BerndGottschlag/goboard/README.md

# GoBoard

This project contains the PCB design and the firmware for a compact modular
wireless mechanical keyboard.

## License

All hardware designes are licensed under the CERN Open Hardware License v1.2.
