BerndGottschlag/goboard/hardware/3dpackages/EG2315A/EG2315A.step

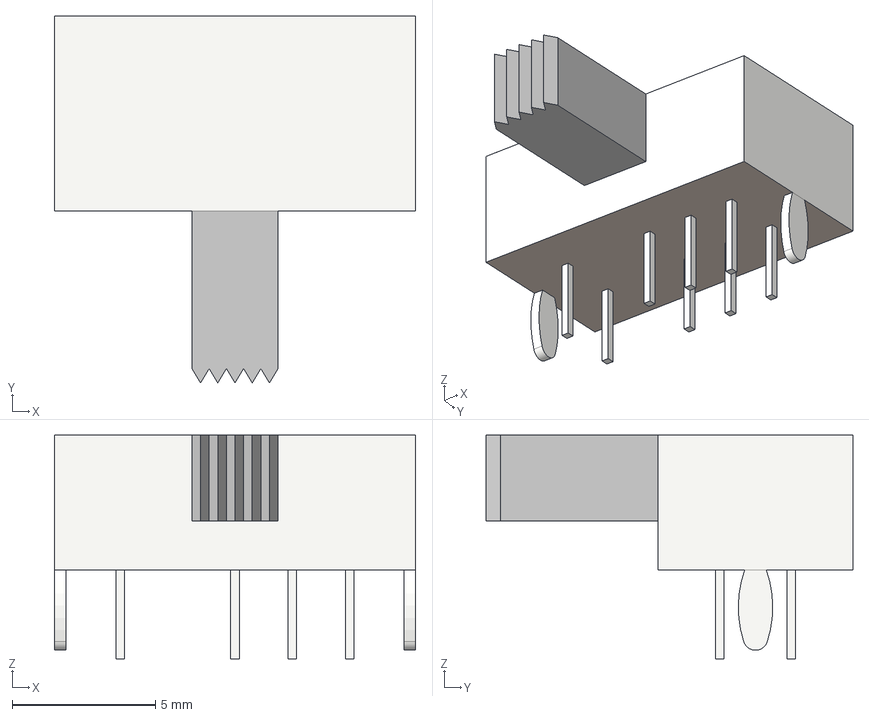
[picture p1: CAD file, 2021-01-24]
hardware/3dpackages/EG2315A/EG2315A.step
12.6 x 12.8 x 7.80 mm
