BerndGottschlag/goboard/hardware/3dpackages/stabilizers/stabilizer_bar_2_00u.FCStd

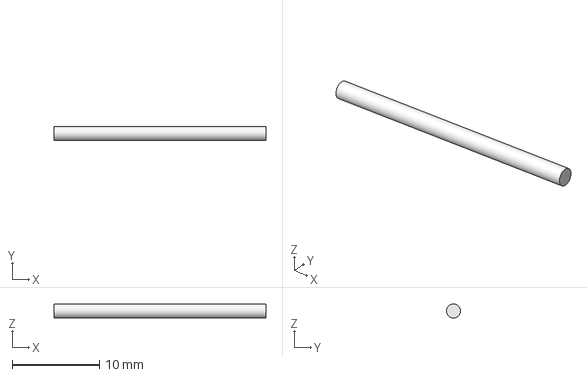
[picture p2: CAD file, 2021-02-06]
hardware/3dpackages/stabilizers/stabilizer_bar_2_00u.FCStd
24.3 x 1.60 x 1.60 mm
