BerndGottschlag/goboard/hardware/3dpackages/stabilizers/stabilizer_6_25u.FCStd

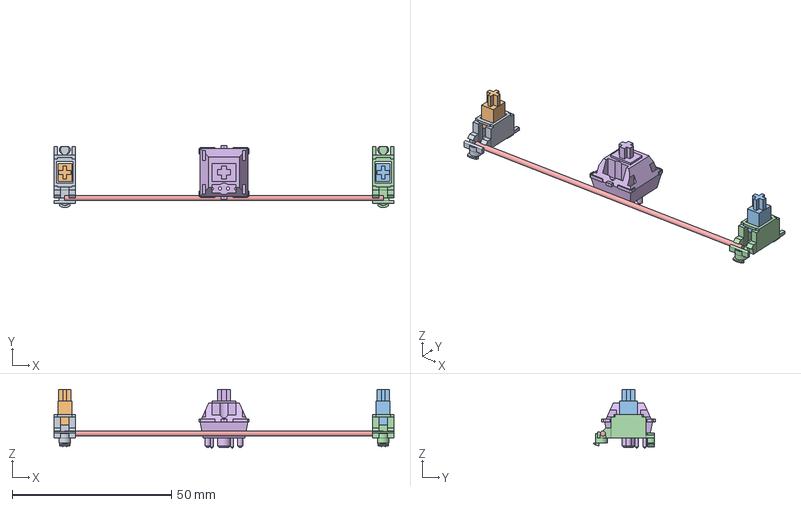
[picture p3: CAD file, 2021-02-06]
hardware/3dpackages/stabilizers/stabilizer_6_25u.FCStd
106.6 x 19.5 x 18.5 mm
stabilizer_body_001
stabilizer_plunger_001
stabilizer_plunger_002
stabilizer_body_002
stabilizer_bar_6_25u_001
SW_Cherry_MX_1.00u_PCB1_001
