BerndGottschlag/goboard/hardware/3dpackages/stabilizers/stabilizer_plunger.FCStd

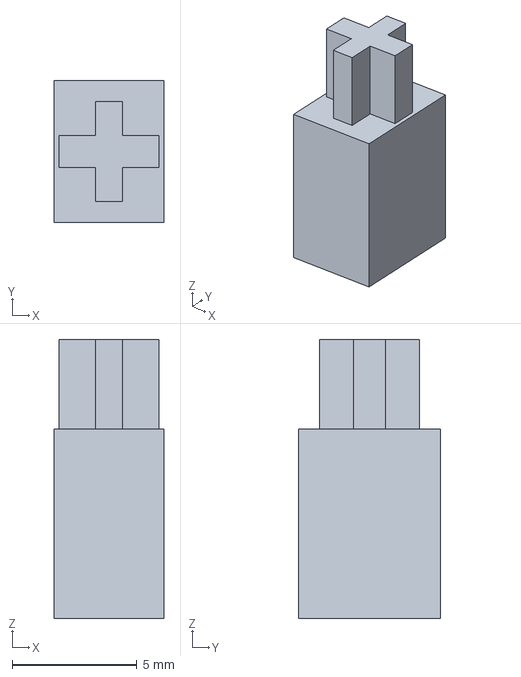
[picture p4: CAD file, 2021-02-06]
hardware/3dpackages/stabilizers/stabilizer_plunger.FCStd
4.40 x 5.70 x 11.2 mm
