BerndGottschlag/goboard/hardware/3dpackages/stabilizers/stabilizer_2_00u.FCStd

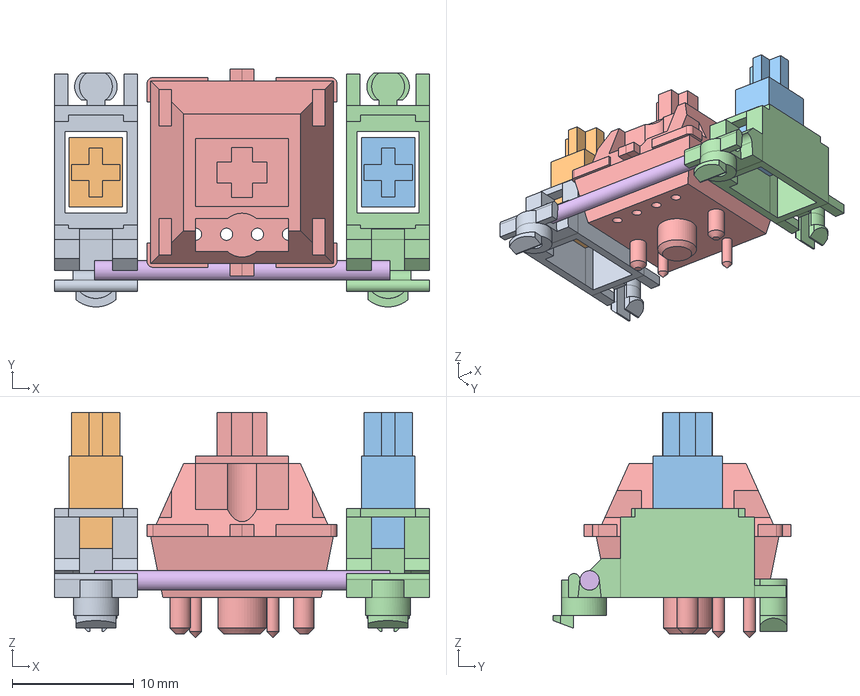
[picture p6: CAD file, 2021-02-06]
hardware/3dpackages/stabilizers/stabilizer_2_00u.FCStd
30.8 x 19.5 x 18.5 mm
stabilizer_body_001
stabilizer_plunger_001
stabilizer_plunger_002
stabilizer_body_002
SW_Cherry_MX_1.00u_PCB1_001
stabilizer_bar_2_00u_001
