BerndGottschlag/goboard/hardware/3dpackages/stabilizers/stabilizer_bar_6_25u.FCStd

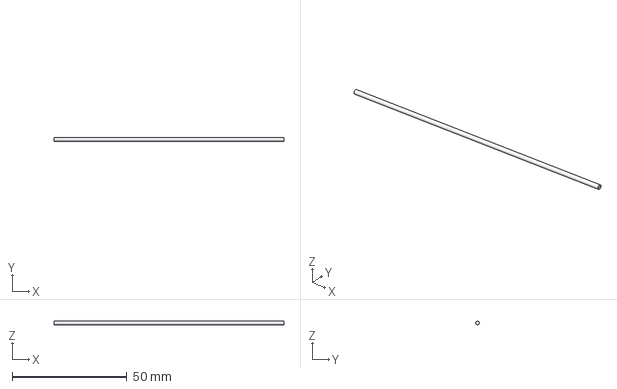
[picture p7: CAD file, 2021-02-06]
hardware/3dpackages/stabilizers/stabilizer_bar_6_25u.FCStd
100.0 x 1.60 x 1.60 mm
