BerndGottschlag/goboard/hardware/3dpackages/stabilizers/stabilizer_body.FCStd

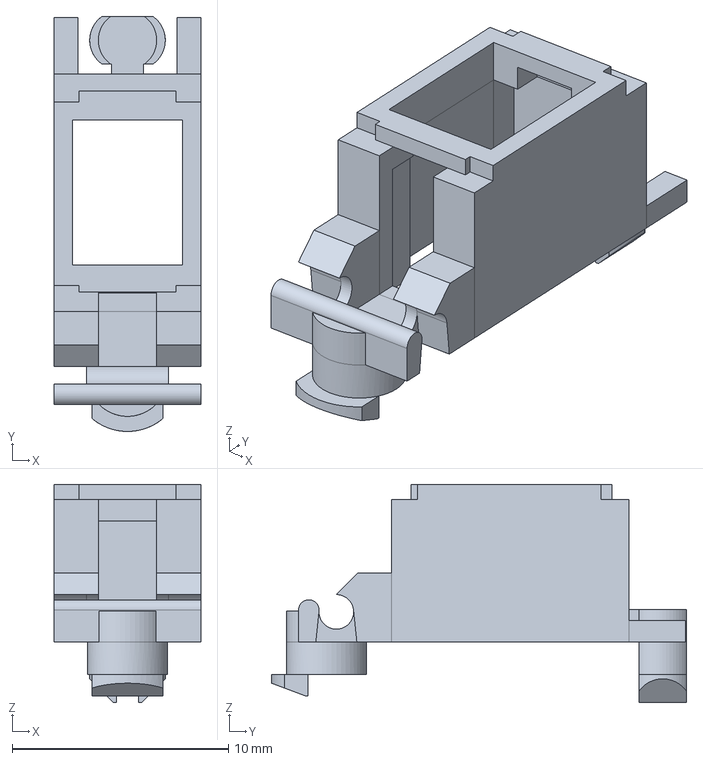
[picture p8: CAD file, 2021-02-06]
hardware/3dpackages/stabilizers/stabilizer_body.FCStd
6.80 x 19.2 x 10.1 mm
