BerndGottschlag/goboard/(list of files, cad)

Other CAD files:
hardware/Batteriehalter_v2.scad
hardware/3dpackages/EG2315A/EG2315A.FCStd
hardware/roundedcube.scad
