BerndGottschlag/goboard/(threads)

Thread 1 (2021-06-07):

How to compile firmware?

mrninhvn, 2021-06-07:
I have limited experience with nrf52-sdk, i still don't understand how to compile the firmware, can you give more instructions?
Thank you!

mgottschlag, 2021-06-07:
Sorry, I forgot to update the README.md when I exchanged the old NRF SDK with the NRF Connect SDK. See commit 54d23b0 for the new instructions.

To install the NRF Connect SDK, follow https://developer.nordicsemi.com/nRF_Connect_SDK/doc/latest/nrf/gs_installing.html - fetching the master branch of  [nrfconnect/sdk-nrf](https://github.com/nrfconnect/sdk-nrf) should work - if not, I am currently on nrfconnect/sdk-nrf@5a8085cd.

mrninhvn, 2021-06-07:
I got that error when building:
`-- Configuring incomplete, errors occurred!
FATAL ERROR: command exited with status 1: 'C:\Program Files\CMake\bin\cmake.EXE' '-DWEST_PYTHON=c:\python39\python.exe' '-BD:\Keyboard\goboard\firmware\main\build' '-SD:\Keyboard\goboard\firmware\main' -GNinja`

And i want to test unifying, how can i switch to unifying mode, thank you.

mgottschlag, 2021-06-20:
Oh, I completely forgot this issue.

1. Unifying code is only working in the old pre-nrf-connect-sdk firmware, i.e. BerndGottschlag/goboard@59bb7e6475d9e5f007e6ed9bba5a2c76e7c1f737. This version requires the regular nrf-sdk and does not use Zephyr. In this case, the old README.md contains the correct instructions to compile the firmware.
2. The error you are seeing is because you do not use the correct version of NCS. You need one with a sufficiently new Zephyr, because the code needs the new work queue API.

mrninhvn, 2021-07-22:
@mgottschlag Finally compiled the firmware, I'm working with this tree [https://github.com/BerndGottschlag/goboard/tree/59bb7e6475d9e5f007e6ed9bba5a2c76e7c1f737](url)
I don't understand how the `main.c` program works, can you explain it to me? Thank you.

mrninhvn, 2021-07-23:
I'm flash code and nothing run, even usb :(

mrninhvn, 2021-07-23:
@mgottschlag So unifying code doesn't work with Zephyr, right?

mrninhvn, 2021-08-28:
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

Hi, i complie [59bb7e6] and flash, but nothing work, even usb, can you help me? I using nrf5sdk 17.0.2, thank you.
