BerndGottschlag/goboard/hardware/numpad/goboard-numpad.kicad_pcb

## KiCad design hardware/numpad/goboard-numpad.kicad_pcb (2021-02-28)

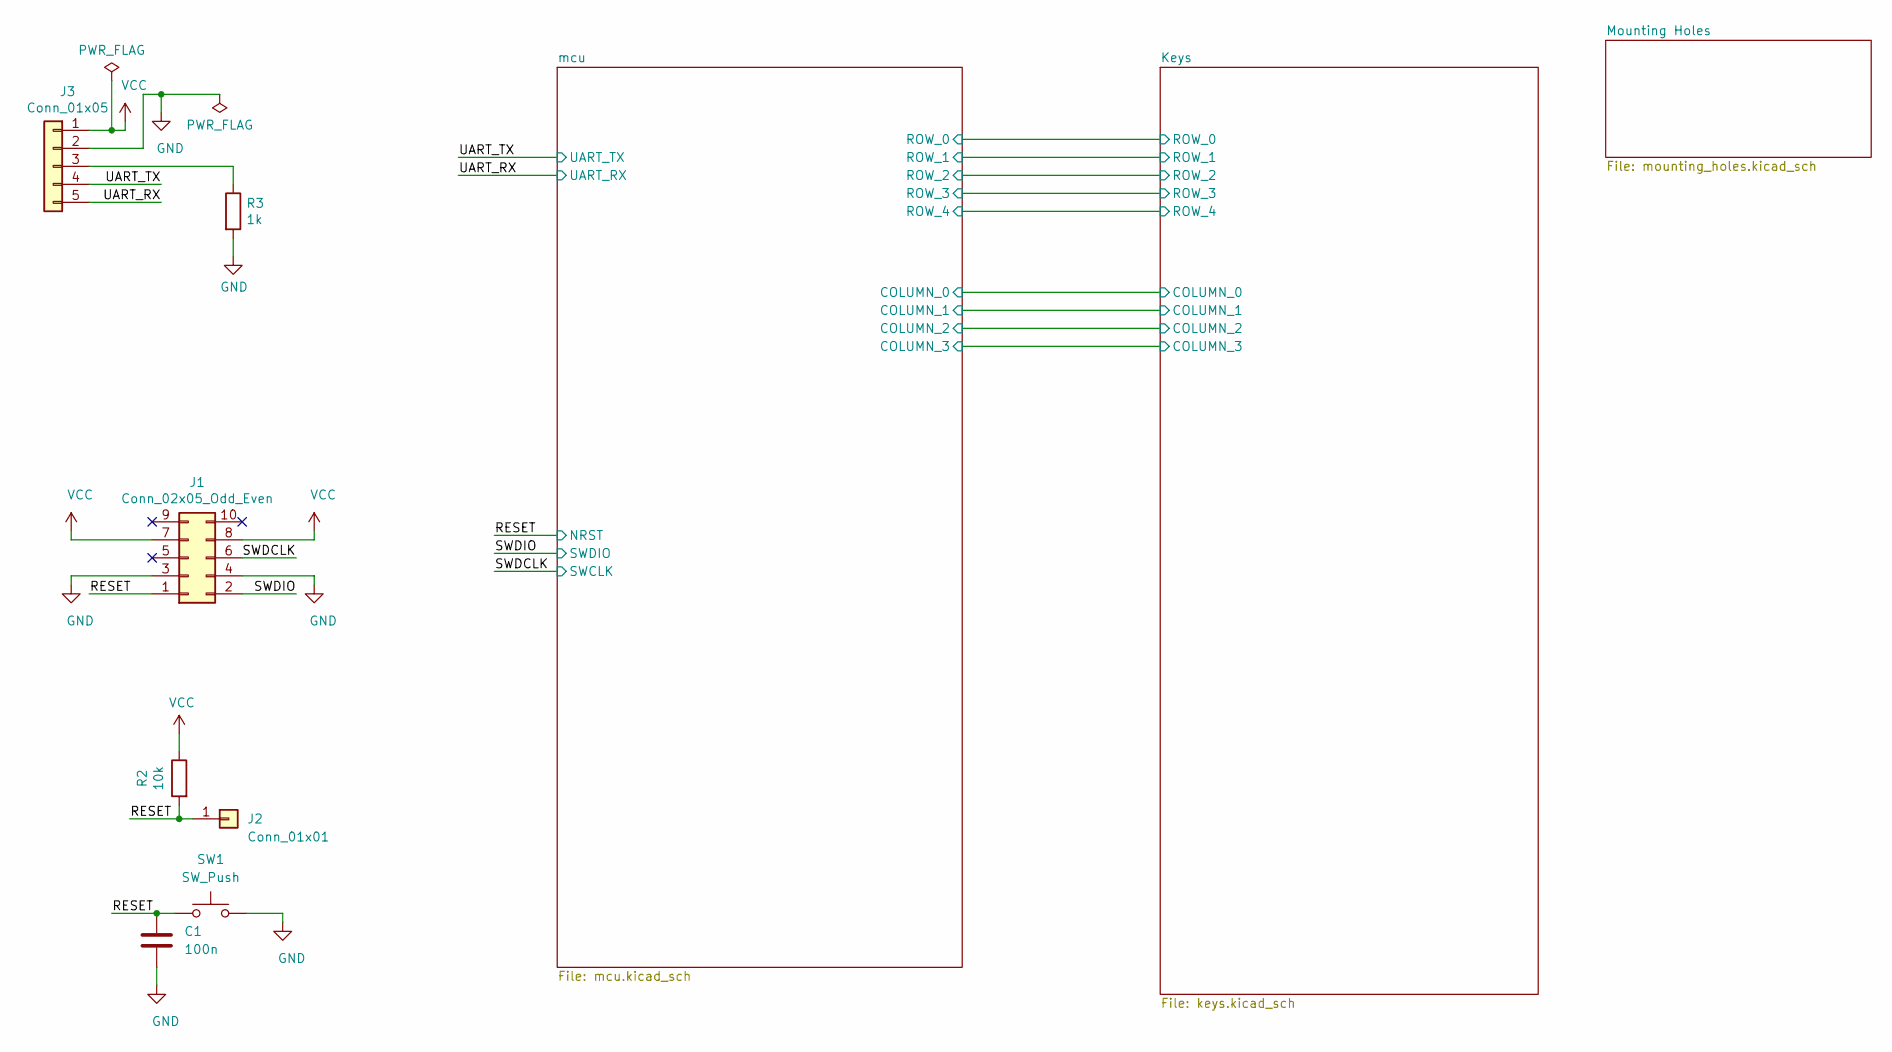
[picture p9: schematic goboard-numpad.kicad_sch]

Parts:
C1: 100n; C_0603_1608Metric_Pad1.08x0.95mm_HandSolder; Part Name AVX 0603YC104MAT4A; Mouser 581-0603YC104MAT4A
J1: Conn_02x05_Odd_Even; programming_port_st_link_clone_without_silkscreen_outline
J2: Conn_01x01; PinHeader_1x01_P2.54mm_Vertical
J3: Conn_01x05; PinHeader_1x05_P2.54mm_Vertical
R2: 10k; R_0603_1608Metric_Pad0.98x0.95mm_HandSolder
R3: 1k; R_0603_1608Metric_Pad0.98x0.95mm_HandSolder
SW1: SW_Push; SW_SPST_CK_RS282G05A3; Part Name PTS636 SM25 SMTR LFS; Mouser 611-PTS636SM25SMTRLF

Connections:
/RESET: C1.1, J1.1, J2.1, R2.2, SW1.1; also elsewhere on the board
/SWDCLK: J1.6; also elsewhere on the board
/SWDIO: J1.2; also elsewhere on the board
/UART_RX: J3.5; also elsewhere on the board
/UART_TX: J3.4; also elsewhere on the board
GND: C1.2, J1.3, J1.4, J3.2, R3.2, SW1.2; also elsewhere on the board
unnamed: J3.3, R3.1
VCC: J1.7, J1.8, J3.1, R2.1; also elsewhere on the board

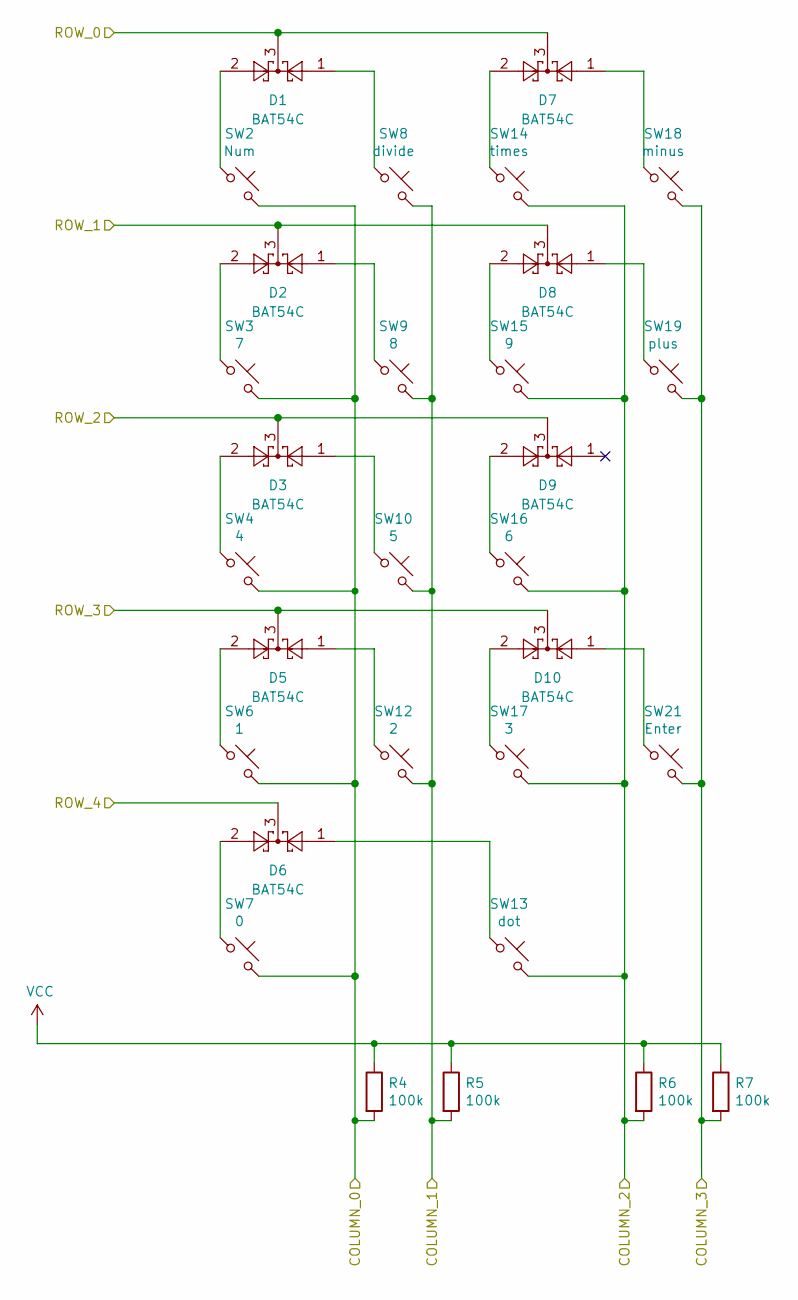
[picture p10: schematic keys.kicad_sch]

Parts:
D1, D2, D3, D5, D6, D7, D8, D9, D10: BAT54C; SOT-23; Part Name BAT54C; Mouser 241-BAT54C_R1_00001
R4, R5, R6, R7: 100k; R_0603_1608Metric_Pad0.98x0.95mm_HandSolder
SW2: Num; SW_Cherry_MX_1.00u_PCB; Part Name MX1A-E1NW; Mouser 540-MX1A-E1NW
SW3: 7; SW_Cherry_MX_1.00u_PCB; Part Name MX1A-E1NW; Mouser 540-MX1A-E1NW
SW4: 4; SW_Cherry_MX_1.00u_PCB; Part Name MX1A-E1NW; Mouser 540-MX1A-E1NW
SW6: 1; SW_Cherry_MX_1.00u_PCB; Part Name MX1A-E1NW; Mouser 540-MX1A-E1NW
SW7: 0; SW_Cherry_MX_2.00u_PCB; Part Name MX1A-E1NW; Mouser 540-MX1A-E1NW
SW8: divide; SW_Cherry_MX_1.00u_PCB; Part Name MX1A-E1NW; Mouser 540-MX1A-E1NW
SW9: 8; SW_Cherry_MX_1.00u_PCB; Part Name MX1A-E1NW; Mouser 540-MX1A-E1NW
SW10: 5; SW_Cherry_MX_1.00u_PCB; Part Name MX1A-E1NW; Mouser 540-MX1A-E1NW
SW12: 2; SW_Cherry_MX_1.00u_PCB; Part Name MX1A-E1NW; Mouser 540-MX1A-E1NW
SW13: dot; SW_Cherry_MX_1.00u_PCB; Part Name MX1A-E1NW; Mouser 540-MX1A-E1NW
SW14: times; SW_Cherry_MX_1.00u_PCB; Part Name MX1A-E1NW; Mouser 540-MX1A-E1NW
SW15: 9; SW_Cherry_MX_1.00u_PCB; Part Name MX1A-E1NW; Mouser 540-MX1A-E1NW
SW16: 6; SW_Cherry_MX_1.00u_PCB; Part Name MX1A-E1NW; Mouser 540-MX1A-E1NW
SW17: 3; SW_Cherry_MX_1.00u_PCB; Part Name MX1A-E1NW; Mouser 540-MX1A-E1NW
SW18: minus; SW_Cherry_MX_1.00u_PCB; Part Name MX1A-E1NW; Mouser 540-MX1A-E1NW
SW19: plus; SW_Cherry_MX_2.00u_PCB; Part Name MX1A-E1NW; Mouser 540-MX1A-E1NW
SW21: Enter; SW_Cherry_MX_2.00u_PCB; Part Name MX1A-E1NW; Mouser 540-MX1A-E1NW

Connections:
/Keys/COLUMN_0: R4.2, SW2.2, SW3.2, SW4.2, SW6.2, SW7.2; also elsewhere on the board
/Keys/COLUMN_1: R5.2, SW8.2, SW9.2, SW10.2, SW12.2; also elsewhere on the board
/Keys/COLUMN_2: R6.2, SW13.2, SW14.2, SW15.2, SW16.2, SW17.2; also elsewhere on the board
/Keys/COLUMN_3: R7.2, SW18.2, SW19.2, SW21.2; also elsewhere on the board
/Keys/ROW_0: D1.3, D7.3; also elsewhere on the board
/Keys/ROW_1: D2.3, D8.3; also elsewhere on the board
/Keys/ROW_2: D3.3, D9.3; also elsewhere on the board
/Keys/ROW_3: D5.3, D10.3; also elsewhere on the board
/Keys/ROW_4: D6.3; also elsewhere on the board
unnamed: D1.1, SW8.1
unnamed: D1.2, SW2.1
unnamed: D2.1, SW9.1
unnamed: D2.2, SW3.1
unnamed: D3.1, SW10.1
unnamed: D3.2, SW4.1
unnamed: D5.1, SW12.1
unnamed: D5.2, SW6.1
unnamed: D6.1, SW13.1
unnamed: D6.2, SW7.1
unnamed: D7.1, SW18.1
unnamed: D7.2, SW14.1
unnamed: D8.1, SW19.1
unnamed: D8.2, SW15.1
unnamed: D9.2, SW16.1
unnamed: D10.1, SW21.1
unnamed: D10.2, SW17.1
VCC: R4.1, R5.1, R6.1, R7.1; also elsewhere on the board

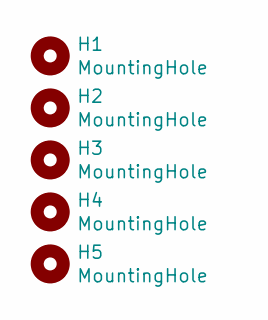
[picture p11: schematic mounting_holes.kicad_sch]

Parts:
H1, H2, H3, H4, H5: MountingHole; MountingHole_2.2mm_M2_Pad

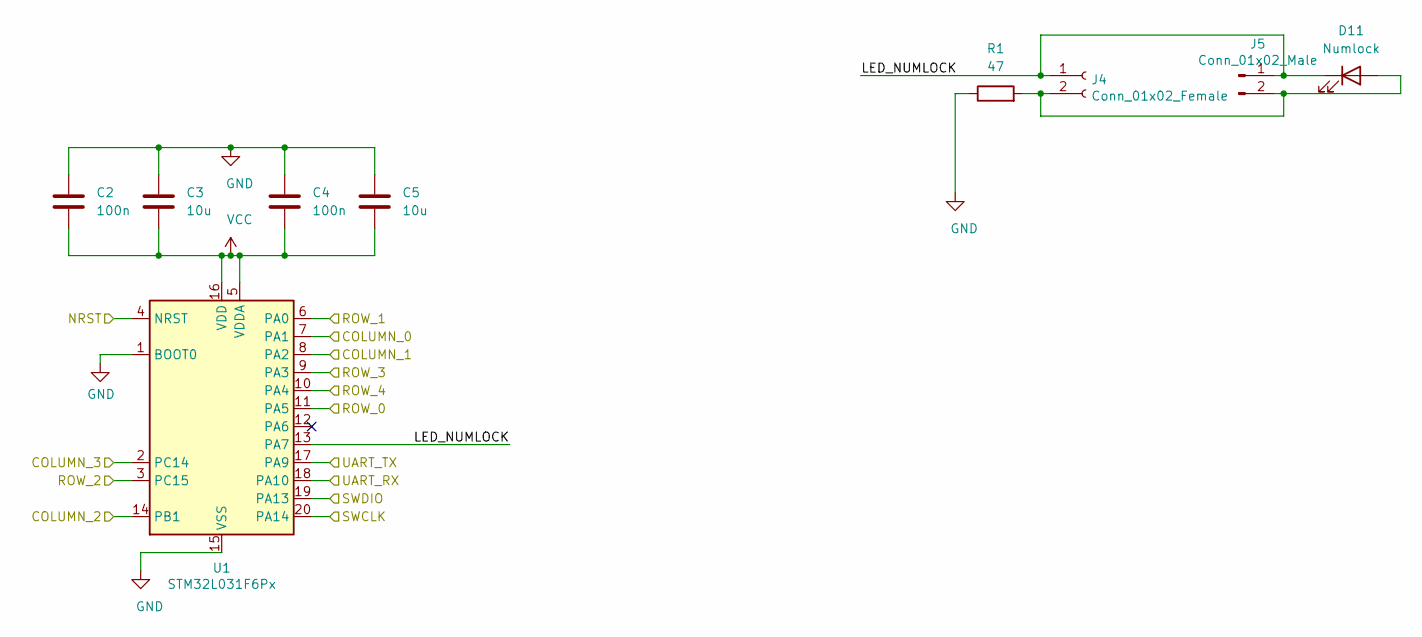
[picture p12: schematic mcu.kicad_sch]

Parts:
C2, C4: 100n; C_0603_1608Metric_Pad1.08x0.95mm_HandSolder; Part Name AVX 0603YC104MAT4A; Mouser 581-0603YC104MAT4A
C3, C5: 10u; C_0805_2012Metric; Part Name Samsung CL21A106KOQNNNG; Mouser 187-CL21A106KOQNNNG
D11: Numlock; D_0603_1608Metric_Pad1.05x0.95mm_HandSolder; Part Name 150060SS75000; Mouser 710-150060SS75000
J4: Conn_01x02_Female; PinSocket_1x02_P2.00mm_Vertical
J5: Conn_01x02_Male; PinSocket_1x02_P2.00mm_Vertical
R1: 47; R_0603_1608Metric_Pad0.98x0.95mm_HandSolder
U1: STM32L031F6Px; TSSOP-20_4.4x6.5mm_P0.65mm; Part Name STM32L031F6P7; Mouser 511-STM32L031F6P7

Connections:
/Keys/COLUMN_0: U1.7 (PA1); also elsewhere on the board
/Keys/COLUMN_1: U1.8 (PA2); also elsewhere on the board
/Keys/COLUMN_2: U1.14 (PB1); also elsewhere on the board
/Keys/COLUMN_3: U1.2 (PC14); also elsewhere on the board
/Keys/ROW_0: U1.11 (PA5); also elsewhere on the board
/Keys/ROW_1: U1.6 (PA0); also elsewhere on the board
/Keys/ROW_2: U1.3 (PC15); also elsewhere on the board
/Keys/ROW_3: U1.9 (PA3); also elsewhere on the board
/Keys/ROW_4: U1.10 (PA4); also elsewhere on the board
/RESET: U1.4 (NRST); also elsewhere on the board
/SWDCLK: U1.20 (PA14); also elsewhere on the board
/SWDIO: U1.19 (PA13); also elsewhere on the board
/UART_RX: U1.18 (PA10); also elsewhere on the board
/UART_TX: U1.17 (PA9); also elsewhere on the board
/mcu/LED_NUMLOCK: D11.1 (K), J4.1, J5.1, U1.13 (PA7)
GND: C2.1, C3.1, C4.1, C5.1, R1.1, U1.1 (BOOT0), U1.15 (VSS); also elsewhere on the board
unnamed: D11.2 (A), J4.2, J5.2, R1.2
VCC: C2.2, C3.2, C4.2, C5.2, U1.5 (VDDA), U1.16 (VDD); also elsewhere on the board

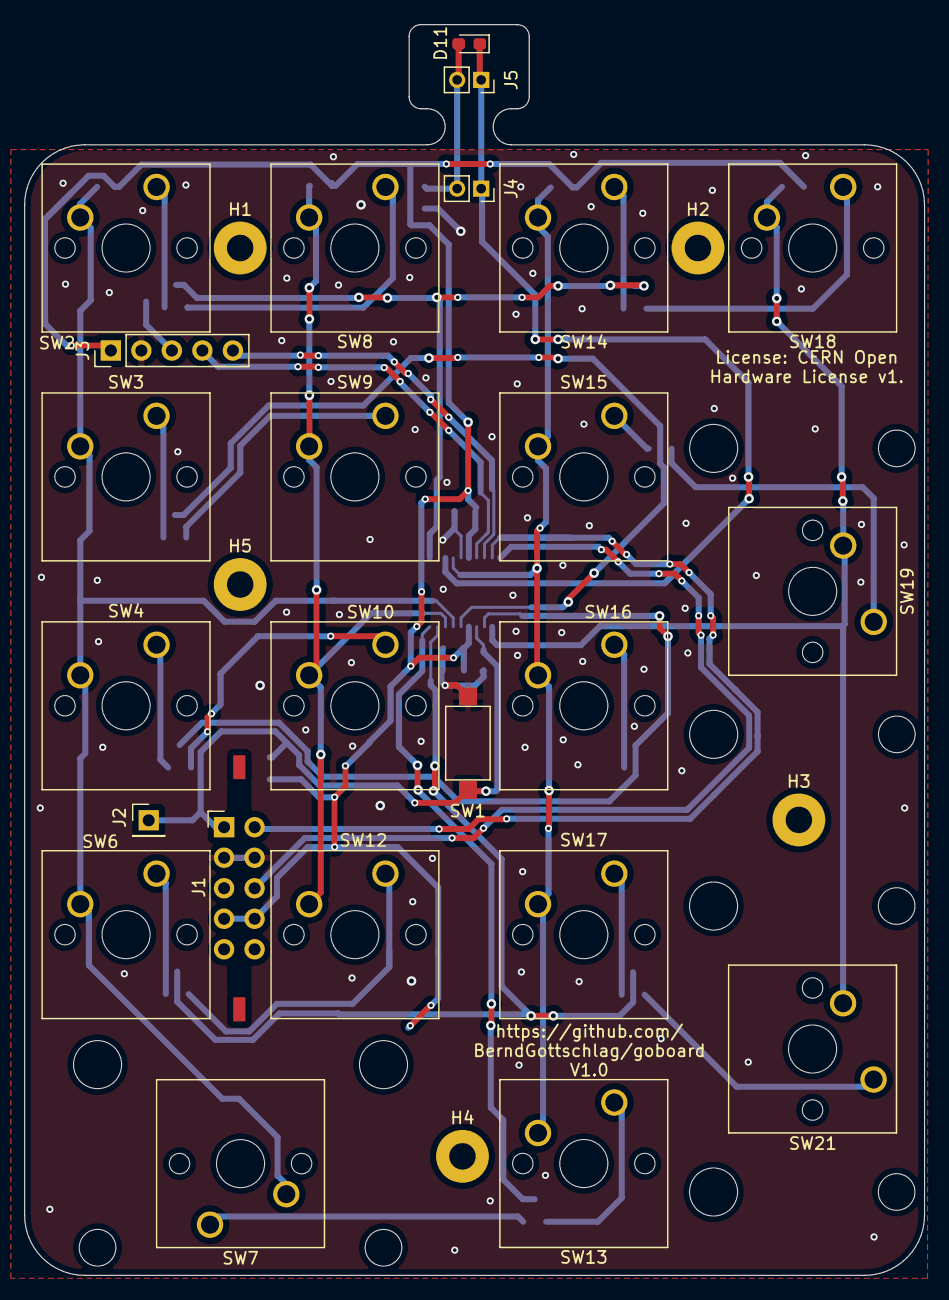
[picture p13: board goboard-numpad.kicad_pcb from above]

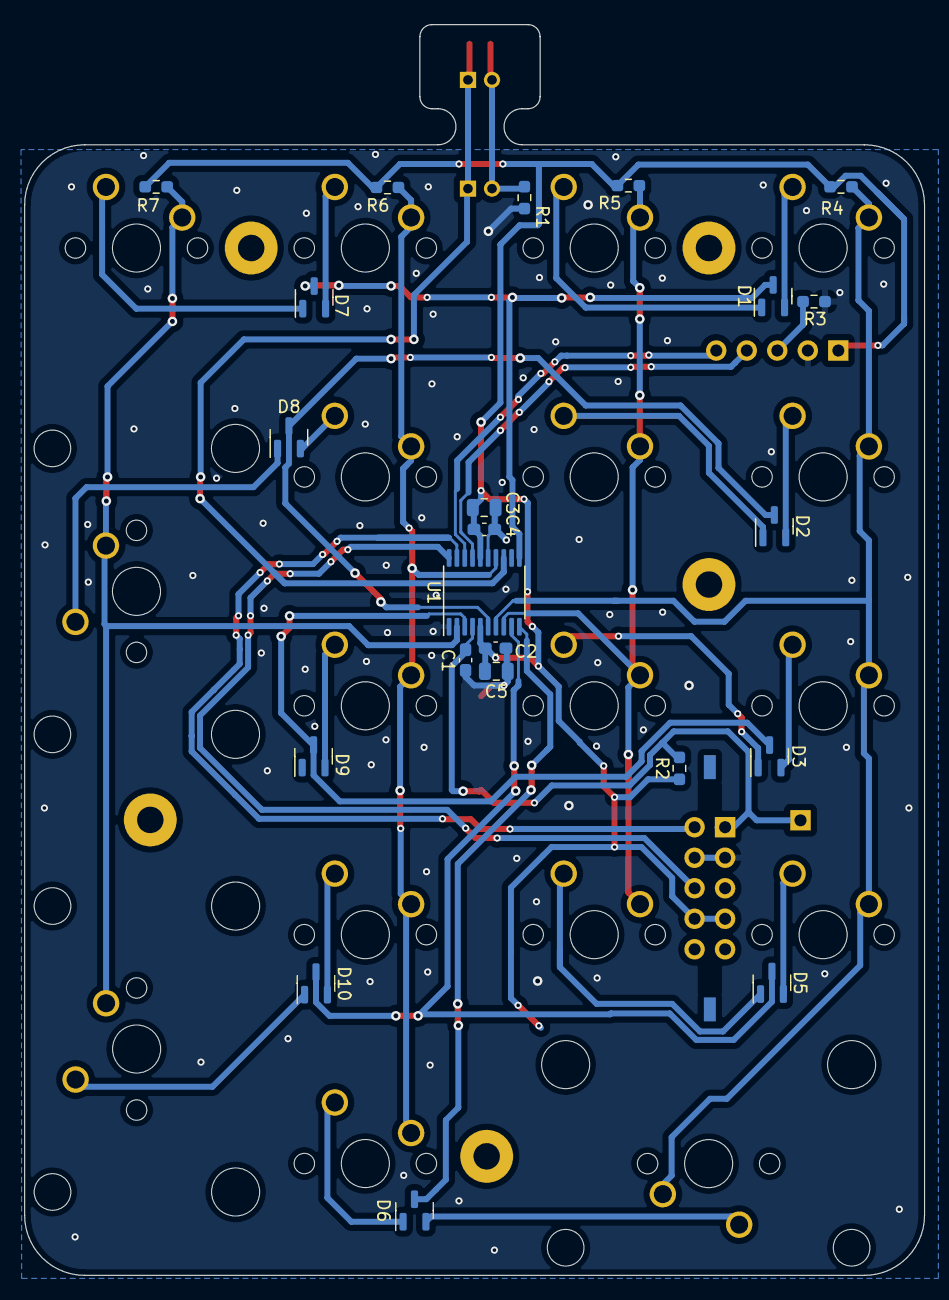
[picture p14: board goboard-numpad.kicad_pcb from below]

Board: 2 copper layers, 74.9 x 104.1 mm, 51 parts (22 on the bottom side), 36 nets.
