BerndGottschlag/goboard/hardware/main/goboard-main.kicad_pcb

## KiCad design hardware/main/goboard-main.kicad_pcb (2021-02-02)

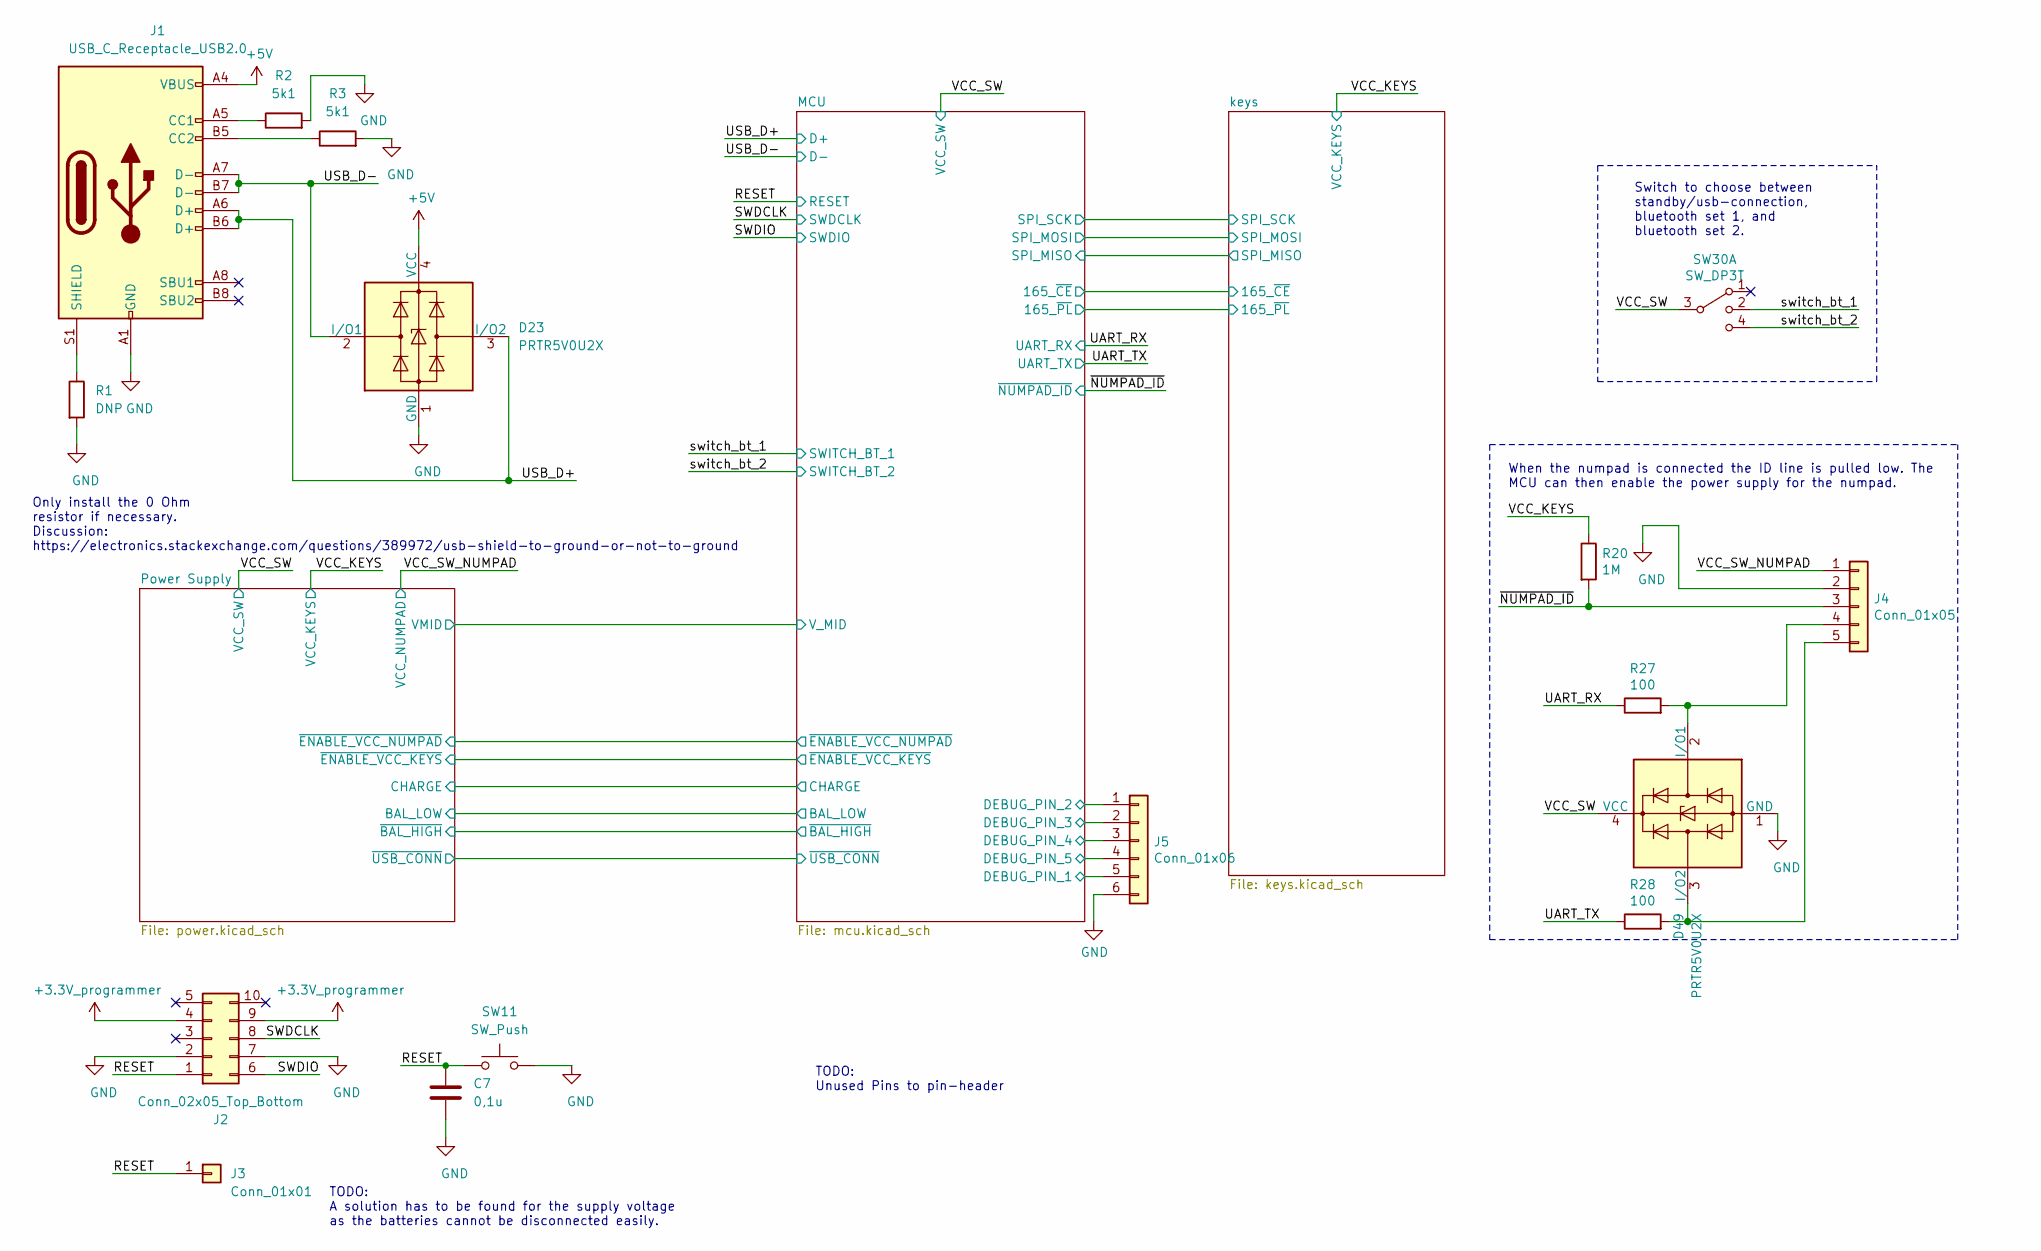
[picture p15: schematic goboard-main.kicad_sch]

Parts:
C7: 0,1u; C_0603_1608Metric_Pad1.08x0.95mm_HandSolder; Part Name 06033C104KAT4A; Mouser 581-06033C104KAT4A
D23, D49: PRTR5V0U2X; SOT-143; Part Name PRTR5V0U2X,215; Mouser 771-PRTR5V0U2X-T/R
J1: USB_C_Receptacle_USB2.0; USB_C_Receptale_JAE_DX07S016JA1R1500; Part Name DX07S016JA1R1500; Mouser 656-DX07S016JA1R1500
J2: Conn_02x05_Top_Bottom; programming_port_st_link_clone
J3: Conn_01x01; PinHeader_1x01_P2.54mm_Vertical
J4: Conn_01x05; PinHeader_1x05_P2.54mm_Vertical
J5: Conn_01x06; PinHeader_1x06_P2.54mm_Vertical
R1: DNP; R_0603_1608Metric_Pad0.98x0.95mm_HandSolder
R2, R3: 5k1; R_0603_1608Metric_Pad0.98x0.95mm_HandSolder
R20: 1M; R_0603_1608Metric_Pad0.98x0.95mm_HandSolder
R27, R28: 100; R_0603_1608Metric_Pad0.98x0.95mm_HandSolder
SW11: SW_Push; SW_SPST_CK_RS282G05A3; Part Name PTS636 SM25 SMTR LFS; Mouser 611-PTS636SM25SMTRLF
SW30: SW_DP3T; EG2315A; Part Name EG2315A; Mouser 612-EG2315A

Connections:
+5V: D23.4 (VCC), J1.A4 (VBUS), J1.A9 (VBUS), J1.B4 (VBUS), J1.B9 (VBUS); also elsewhere on the board
/MCU/DEBUG_PIN_1: J5.5; also elsewhere on the board
/MCU/DEBUG_PIN_2: J5.1; also elsewhere on the board
/MCU/DEBUG_PIN_3: J5.2; also elsewhere on the board
/MCU/DEBUG_PIN_4: J5.3; also elsewhere on the board
/MCU/DEBUG_PIN_5: J5.4; also elsewhere on the board
/RESET: C7.1, J2.1, J3.1, SW11.1; also elsewhere on the board
/SWDCLK: J2.8; also elsewhere on the board
/SWDIO: J2.6; also elsewhere on the board
/UART_RX: R27.1; also elsewhere on the board
/UART_TX: R28.1; also elsewhere on the board
/USB_D+: D23.3 (I/O2), J1.A6 (D+), J1.B6 (D+); also elsewhere on the board
/USB_D-: D23.2 (I/O1), J1.A7 (D-), J1.B7 (D-); also elsewhere on the board
/VCC_KEYS: R20.1; also elsewhere on the board
/VCC_SW: D49.4 (VCC), SW30.3; also elsewhere on the board
/VCC_SW_NUMPAD: J4.1; also elsewhere on the board
/switch_bt_1: SW30.2; also elsewhere on the board
/switch_bt_2: SW30.4; also elsewhere on the board
/~NUMPAD_ID: J4.3, R20.2; also elsewhere on the board
GND: C7.2, D23.1 (GND), D49.1 (GND), J1.A1 (GND), J1.A12 (GND), J1.B1 (GND), J1.B12 (GND), J2.2, J2.7, J4.2, J5.6, R1.2, R2.2, R3.2, SW11.2; also elsewhere on the board
unnamed: D49.2 (I/O1), J4.4, R27.2
unnamed: D49.3 (I/O2), J4.5, R28.2
unnamed: J1.A5 (CC1), R2.1
unnamed: J1.B5 (CC2), R3.1
unnamed: J1.S1 (SHIELD), R1.1

Notes on the sheet:
Only install the 0 Ohm resistor if necessary. Discussion: https://electronics.stackexchange.com/questions/389972/usb-shield-to-ground-or-not-to-ground
TODO: A solution has to be found for the supply voltage as the batteries cannot be disconnected easily.
TODO: Unused Pins to pin-header
When the numpad is connected the ID line is pulled low. The MCU can then enable the power supply for the numpad.
Switch to choose between standby/usb-connection, bluetooth set 1, and bluetooth set 2.

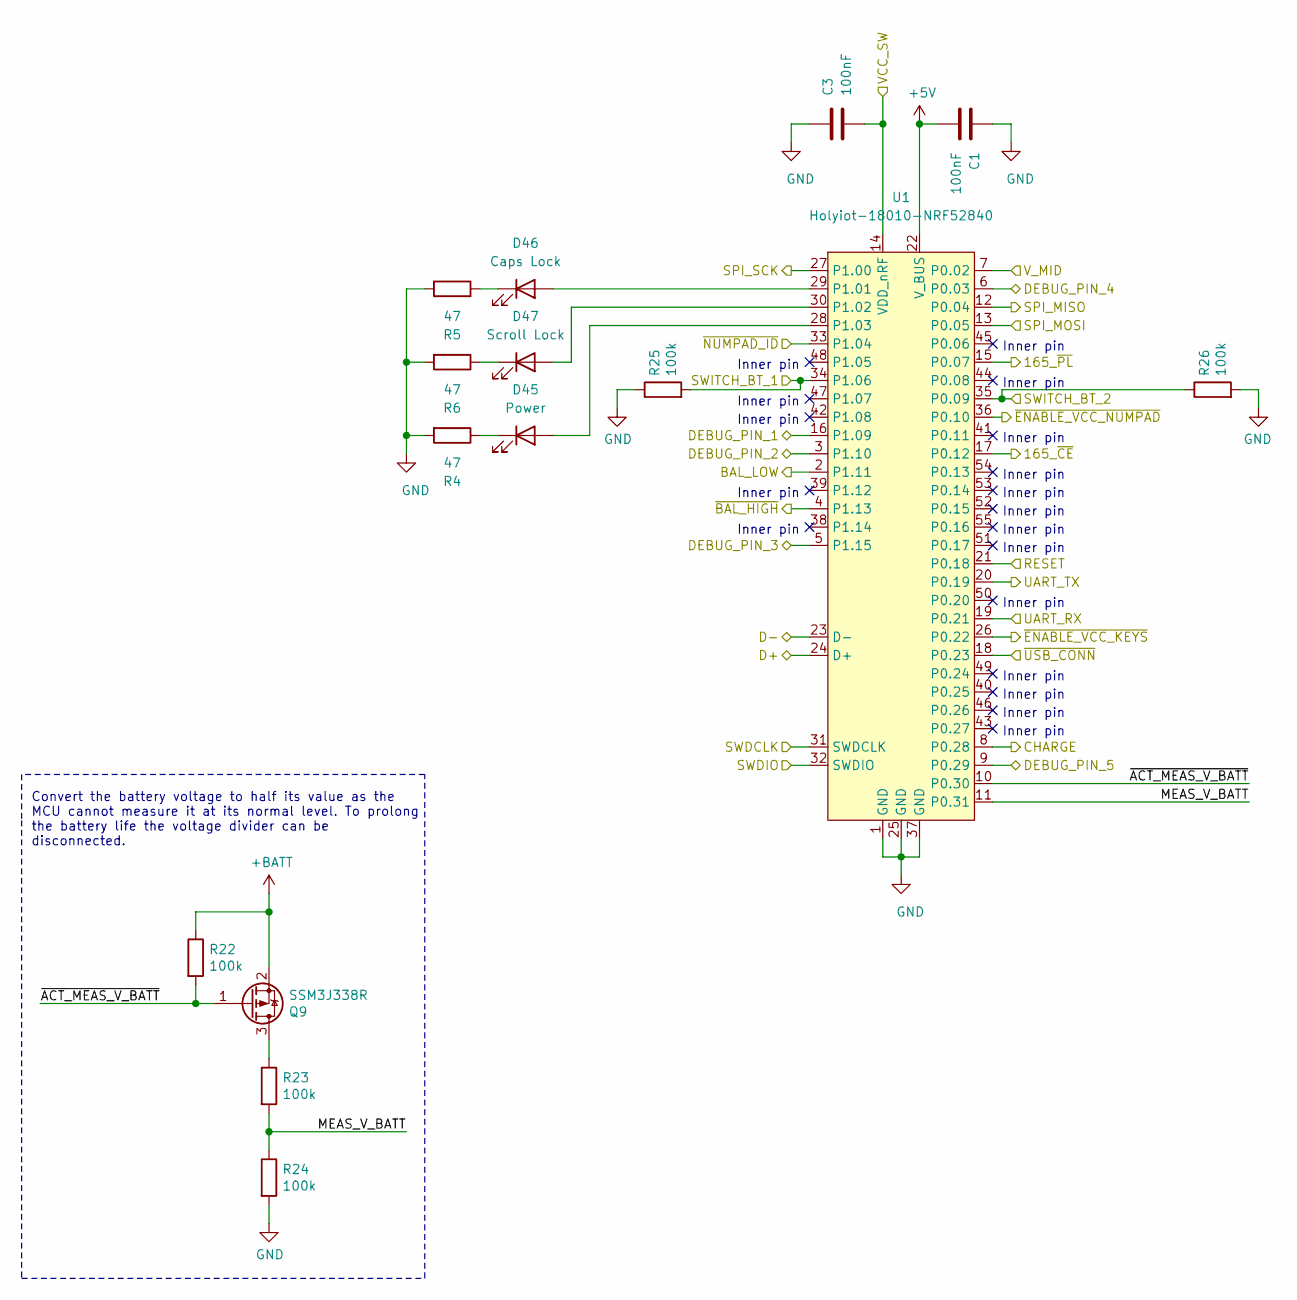
[picture p16: schematic mcu.kicad_sch]

Parts:
C1, C3: 100nF; C_0603_1608Metric_Pad1.08x0.95mm_HandSolder; Part Name 06033C104KAT4A; Mouser 581-06033C104KAT4A
D45: Power; D_0603_1608Metric_Pad1.05x0.95mm_HandSolder; Part Name 150060SS75000; Mouser 710-150060SS75000
D46: Caps Lock; D_0603_1608Metric_Pad1.05x0.95mm_HandSolder; Part Name 150060SS75000; Mouser 710-150060SS75000
D47: Scroll Lock; D_0603_1608Metric_Pad1.05x0.95mm_HandSolder; Part Name 150060SS75000; Mouser 710-150060SS75000
Q9: SSM3J338R; SOT-23_Handsoldering; Part Name Toshiba SSM3J338R; Mouser 757-SSM3J338RLF
R4, R5, R6: 47; R_0603_1608Metric_Pad0.98x0.95mm_HandSolder
R22, R23, R24, R25, R26: 100k; R_0603_1608Metric_Pad0.98x0.95mm_HandSolder
U1: Holyiot-18010-NRF52840

Connections:
+5V: C1.2, U1.22 (V_BUS); also elsewhere on the board
+BATT: Q9.2 (S), R22.1; also elsewhere on the board
/MCU/165_~CE: U1.17 (P0.12); also elsewhere on the board
/MCU/165_~PL: U1.15 (P0.07); also elsewhere on the board
/MCU/BAL_LOW: U1.2 (P1.11); also elsewhere on the board
/MCU/CHARGE: U1.8 (P0.28); also elsewhere on the board
/MCU/DEBUG_PIN_1: U1.16 (P1.09); also elsewhere on the board
/MCU/DEBUG_PIN_2: U1.3 (P1.10); also elsewhere on the board
/MCU/DEBUG_PIN_3: U1.5 (P1.15); also elsewhere on the board
/MCU/DEBUG_PIN_4: U1.6 (P0.03); also elsewhere on the board
/MCU/DEBUG_PIN_5: U1.9 (P0.29); also elsewhere on the board
/MCU/MEAS_V_BATT: R23.2, R24.1, U1.11 (P0.31)
/MCU/SPI_MISO: U1.12 (P0.04); also elsewhere on the board
/MCU/SPI_MOSI: U1.13 (P0.05); also elsewhere on the board
/MCU/SPI_SCK: U1.27 (P1.00); also elsewhere on the board
/MCU/V_MID: U1.7 (P0.02); also elsewhere on the board
/MCU/~ACT_MEAS_V_BATT: Q9.1 (G), R22.2, U1.10 (P0.30)
/MCU/~BAL_HIGH: U1.4 (P1.13); also elsewhere on the board
/MCU/~ENABLE_VCC_KEYS: U1.26 (P0.22); also elsewhere on the board
/MCU/~ENABLE_VCC_NUMPAD: U1.36 (P0.10); also elsewhere on the board
/MCU/~USB_CONN: U1.18 (P0.23); also elsewhere on the board
/RESET: U1.21 (P0.18); also elsewhere on the board
/SWDCLK: U1.31 (SWDCLK); also elsewhere on the board
/SWDIO: U1.32 (SWDIO); also elsewhere on the board
/UART_RX: U1.19 (P0.21); also elsewhere on the board
/UART_TX: U1.20 (P0.19); also elsewhere on the board
/USB_D+: U1.24 (D+); also elsewhere on the board
/USB_D-: U1.23 (D-); also elsewhere on the board
/VCC_SW: C3.2, U1.14 (VDD_nRF); also elsewhere on the board
/switch_bt_1: R25.2, U1.34 (P1.06); also elsewhere on the board
/switch_bt_2: R26.1, U1.35 (P0.09); also elsewhere on the board
/~NUMPAD_ID: U1.33 (P1.04); also elsewhere on the board
GND: C1.1, C3.1, R4.2, R5.2, R6.2, R24.2, R25.1, R26.2, U1.1 (GND), U1.25 (GND), U1.37 (GND); also elsewhere on the board
unnamed: D45.1 (K), R4.1
unnamed: D45.2 (A), U1.28 (P1.03)
unnamed: D46.1 (K), R5.1
unnamed: D46.2 (A), U1.29 (P1.01)
unnamed: D47.1 (K), R6.1
unnamed: D47.2 (A), U1.30 (P1.02)
unnamed: Q9.3 (D), R23.1

Notes on the sheet:
Convert the battery voltage to half its value as the MCU cannot measure it at its normal level. To prolong the battery life the voltage divider can be disconnected.
Inner pin

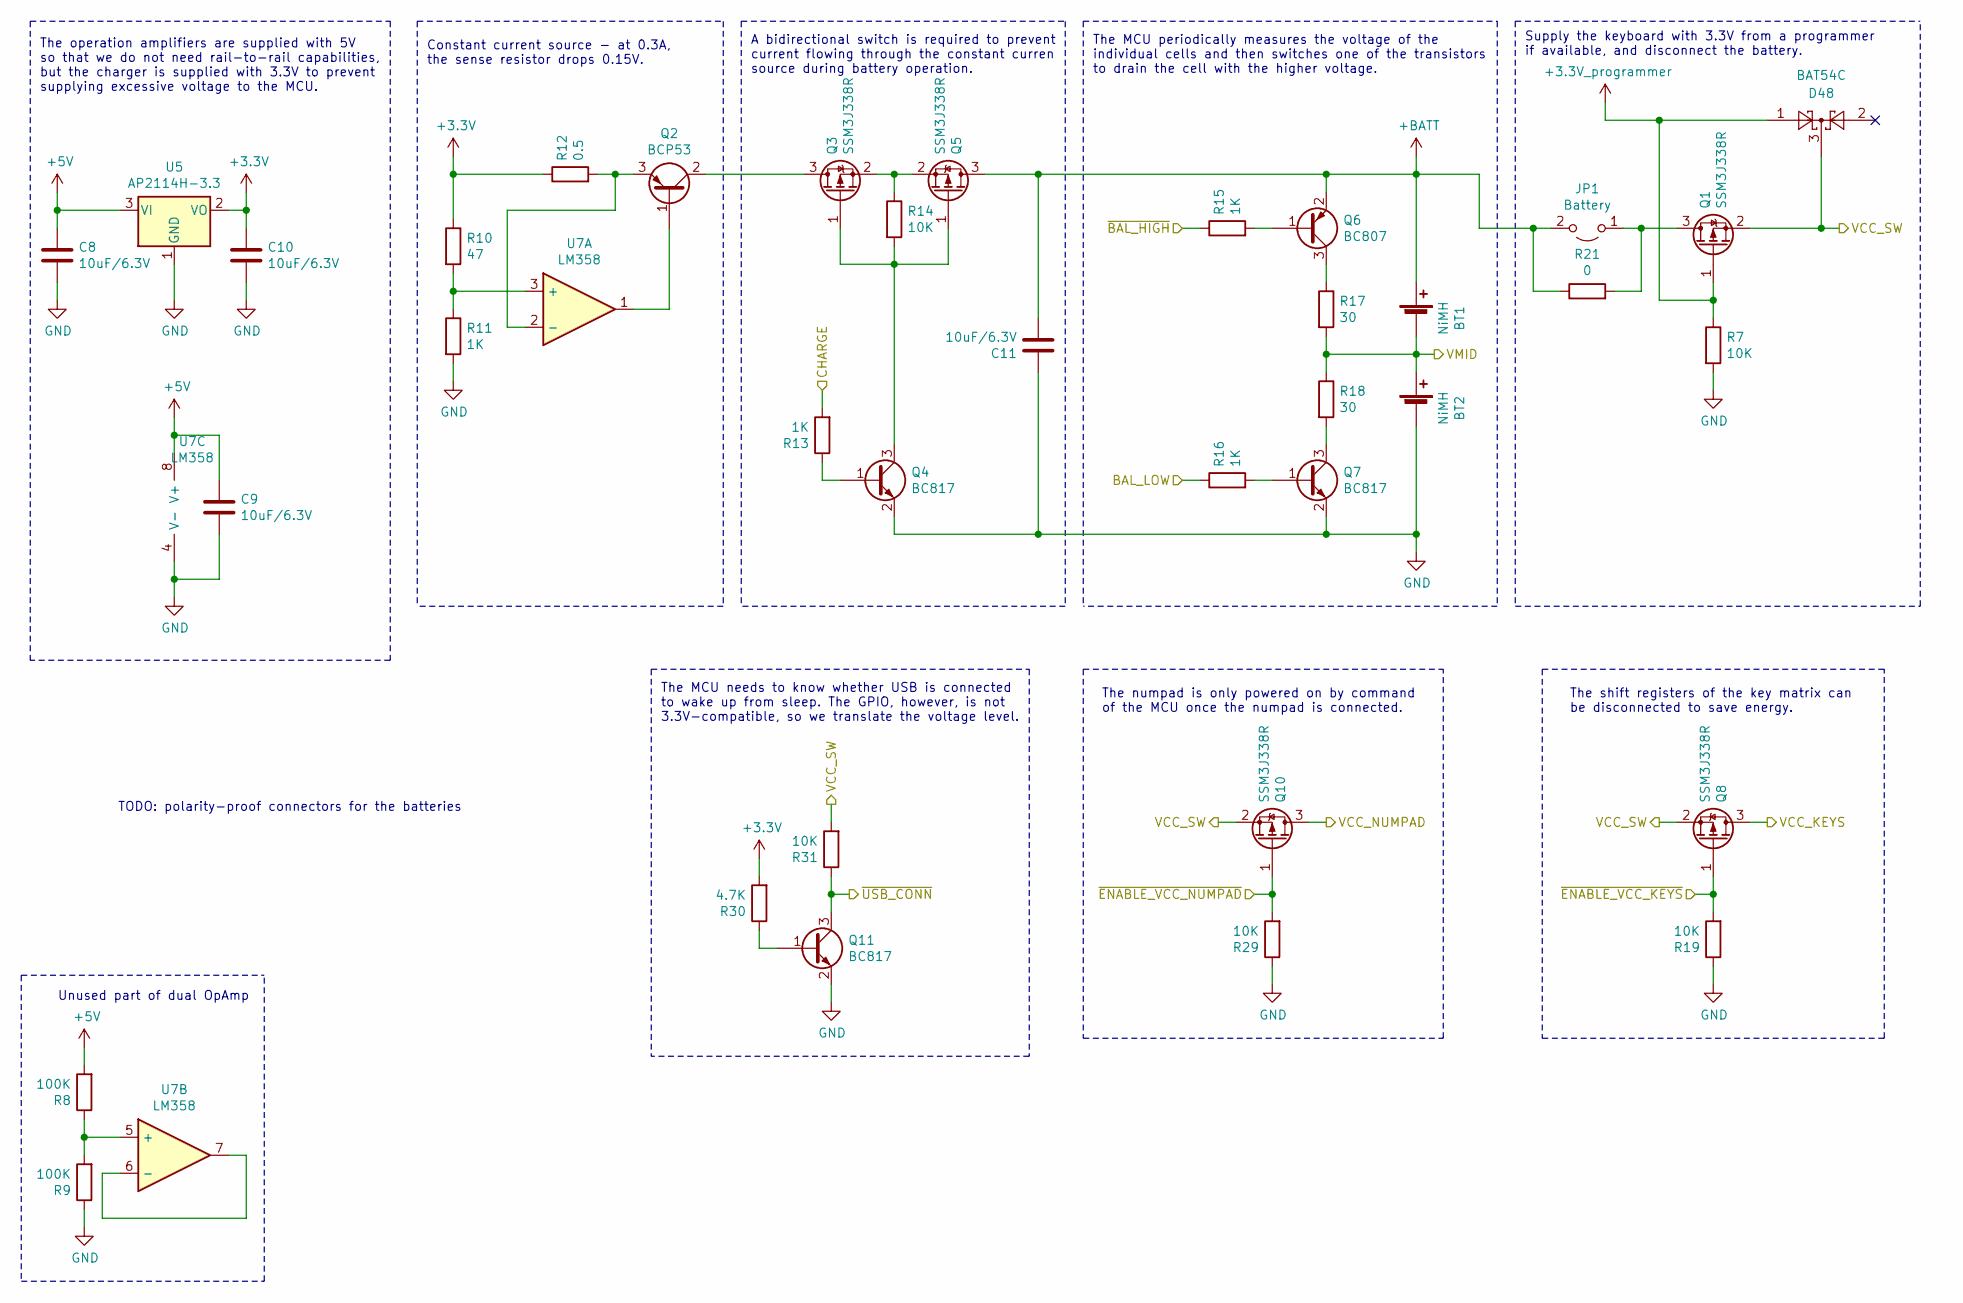
[picture p17: schematic power.kicad_sch]

Parts:
BT1, BT2: NiMH; JST_XH_S2B-XH-A_1x02_P2.50mm_Horizontal
C8, C9, C10, C11: 10uF/6.3V; C_0805_2012Metric; Part Name Taiyo Yuden LMK212F106ZG-T; Mouser 963-LMK212F106ZG-T
D48: BAT54C; SOT-23; Part Name BAT54A; Mouser 241-BAT54A_R1_00001
JP1: Battery; PinHeader_1x02_P2.54mm_Horizontal
Q1, Q3, Q5, Q8, Q10: SSM3J338R; SOT-23_Handsoldering; Part Name Toshiba SSM3J338R; Mouser 757-SSM3J338RLF
Q2: BCP53; SOT-223; Part Name Nexperia BCP53TF; Mouser 771-BCP53TF
Q4, Q7, Q11: BC817; SOT-23
Q6: BC807; SOT-23
R7, R14, R19, R29, R31: 10K; R_0603_1608Metric
R8, R9: 100K; R_0603_1608Metric
R10: 47; R_0603_1608Metric
R11, R13, R15, R16: 1K; R_0603_1608Metric
R12: 0.5; R_1206_3216Metric; Part Name Ohmite KDV12FR510ET; Mouser 588-KDV12FR510ET
R17, R18: 30; R_0603_1608Metric
R21: 0; R_0603_1608Metric_Pad0.98x0.95mm_HandSolder
R30: 4.7K; R_0603_1608Metric
U5: AP2114H-3.3; SOT-223-3_TabPin2; Part Name Diodes Inc AP2114H-3.3TRG1; Mouser 621-AP2114H-3.3TRG1
U7: LM358

Connections:
+5V: C8.1, C9.1, R8.2, U5.3 (VI), U7.8 (V+); also elsewhere on the board
+BATT: BT1.1 (+), C11.2, JP1.2 (B), Q5.3 (D), Q6.2 (E), R21.1; also elsewhere on the board
/MCU/BAL_LOW: R16.1; also elsewhere on the board
/MCU/CHARGE: R13.2; also elsewhere on the board
/MCU/V_MID: BT1.2 (-), BT2.1 (+), R17.2, R18.1; also elsewhere on the board
/MCU/~BAL_HIGH: R15.1; also elsewhere on the board
/MCU/~ENABLE_VCC_KEYS: Q8.1 (G), R19.2; also elsewhere on the board
/MCU/~ENABLE_VCC_NUMPAD: Q10.1 (G), R29.2; also elsewhere on the board
/MCU/~USB_CONN: Q11.3 (C), R31.1; also elsewhere on the board
/VCC_KEYS: Q8.3 (D); also elsewhere on the board
/VCC_SW: D48.3, Q1.2 (S), Q8.2 (S), Q10.2 (S), R31.2; also elsewhere on the board
/VCC_SW_NUMPAD: Q10.3 (D); also elsewhere on the board
GND: BT2.2 (-), C8.2, C9.2, C10.2, C11.1, Q4.2 (E), Q7.2 (E), Q11.2 (E), R7.2, R9.1, R11.2, R19.1, R29.1, U5.1 (GND), U7.4 (V-); also elsewhere on the board
unnamed: JP1.1 (A), Q1.3 (D), R21.2
unnamed: Q2.1 (B), U7.1
unnamed: Q2.2 (C), Q2.4 (C), Q3.3 (D)
unnamed: Q2.3 (E), R12.2, U7.2 (-)
unnamed: Q3.1 (G), Q4.3 (C), Q5.1 (G), R14.2
unnamed: Q3.2 (S), Q5.2 (S), R14.1
unnamed: Q4.1 (B), R13.1
unnamed: Q6.1 (B), R15.2
unnamed: Q6.3 (C), R17.1
unnamed: Q7.1 (B), R16.2
unnamed: Q7.3 (C), R18.2
unnamed: Q11.1 (B), R30.1
unnamed: R8.1, R9.2, U7.5 (+)
unnamed: R10.2, R11.1, U7.3 (+)
unnamed: U7.6 (-), U7.7

Notes on the sheet:
The operation amplifiers are supplied with 5V so that we do not need rail-to-rail capabilities, but the charger is supplied with 3.3V to prevent supplying excessive voltage to the MCU.
Unused part of dual OpAmp
Constant current source - at 0.3A, the sense resistor drops 0.15V.
TODO: polarity-proof connectors for the batteries
The MCU needs to know whether USB is connected to wake up from sleep. The GPIO, however, is not 3.3V-compatible, so we translate the voltage level.
A bidirectional switch is required to prevent current flowing through the constant curren source during battery operation.
The MCU periodically measures the voltage of the individual cells and then switches one of the transistors to drain the cell with the higher voltage.
The numpad is only powered on by command of the MCU once the numpad is connected.
Supply the keyboard with 3.3V from a programmer if available, and disconnect the battery.
The shift registers of the key matrix can be disconnected to save energy.
