BerndGottschlag/goboard/hardware/main/goboard-main.kicad_pcb

## KiCad design hardware/main/goboard-main.kicad_pcb (continued)

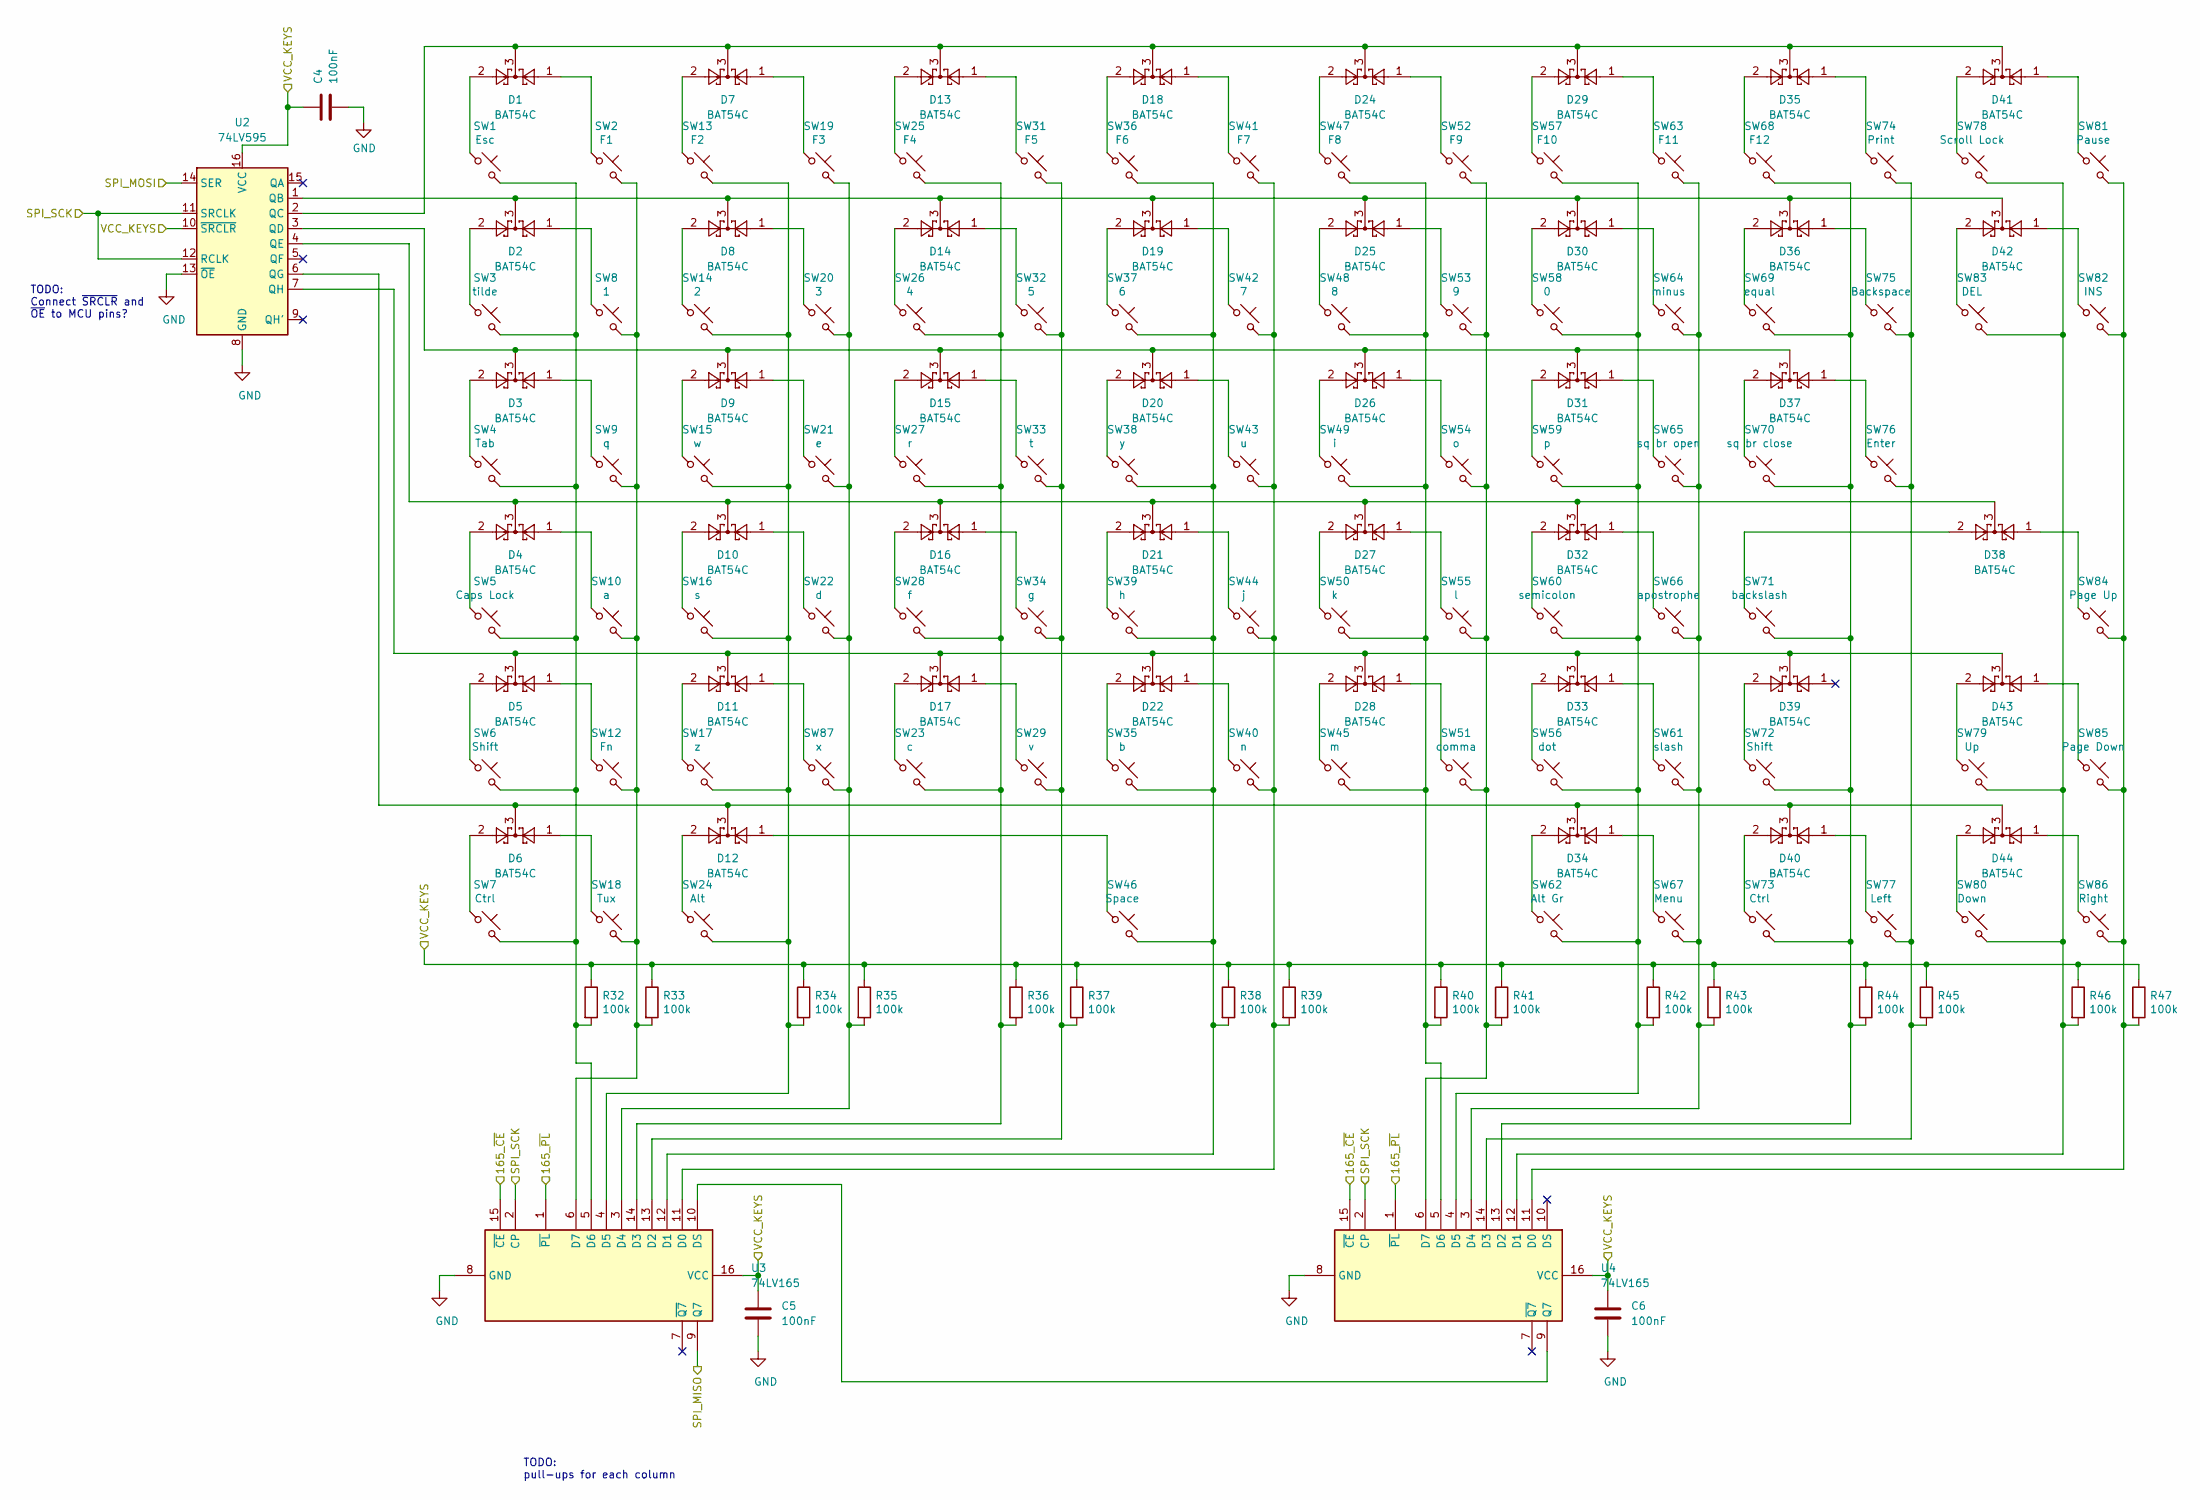
[picture p18: schematic keys.kicad_sch]

Parts:
C4, C5, C6: 100nF; C_0603_1608Metric_Pad1.08x0.95mm_HandSolder; Part Name 06033C104KAT4A; Mouser 581-06033C104KAT4A
D1, D2, D3, D4, D5, D6, D7, D8, D9, D10, D11, D12, D13, D14, D15, D16, D17, D18, D19, D20, D21, D22, D24, D25, D26, D27, D28, D29, D30, D31, D32, D33, D34, D35, D36, D37, D38, D39, D40, D41, D42, D43, D44: BAT54C; SOT-23; Part Name BAT54A; Mouser 241-BAT54A_R1_00001
R32, R33, R34, R35, R36, R37, R38, R39, R40, R41, R42, R43, R44, R45, R46, R47: 100k; R_0603_1608Metric_Pad0.98x0.95mm_HandSolder
SW1: Esc; SW_Cherry_MX_1.00u_PCB; Part Name MX1A-E1NW; Mouser 540-MX1A-E1NW
SW2: F1; SW_Cherry_MX_1.00u_PCB; Part Name MX1A-E1NW; Mouser 540-MX1A-E1NW
SW3: tilde; SW_Cherry_MX_1.00u_PCB; Part Name MX1A-E1NW; Mouser 540-MX1A-E1NW
SW4: Tab; SW_Cherry_MX_1.50u_PCB; Part Name MX1A-E1NW; Mouser 540-MX1A-E1NW
SW5: Caps Lock; SW_Cherry_MX_1.75u_PCB; Part Name MX1A-E1NW; Mouser 540-MX1A-E1NW
SW6: Shift; SW_Cherry_MX_1.25u_PCB; Part Name MX1A-E1NW; Mouser 540-MX1A-E1NW
SW7: Ctrl; SW_Cherry_MX_1.25u_PCB; Part Name MX1A-E1NW; Mouser 540-MX1A-E1NW
SW8: 1; SW_Cherry_MX_1.00u_PCB; Part Name MX1A-E1NW; Mouser 540-MX1A-E1NW
SW9: q; SW_Cherry_MX_1.00u_PCB; Part Name MX1A-E1NW; Mouser 540-MX1A-E1NW
SW10: a; SW_Cherry_MX_1.00u_PCB; Part Name MX1A-E1NW; Mouser 540-MX1A-E1NW
SW12: Fn; SW_Cherry_MX_1.00u_PCB; Part Name MX1A-E1NW; Mouser 540-MX1A-E1NW
SW13: F2; SW_Cherry_MX_1.00u_PCB; Part Name MX1A-E1NW; Mouser 540-MX1A-E1NW
SW14: 2; SW_Cherry_MX_1.00u_PCB; Part Name MX1A-E1NW; Mouser 540-MX1A-E1NW
SW15: w; SW_Cherry_MX_1.00u_PCB; Part Name MX1A-E1NW; Mouser 540-MX1A-E1NW
SW16: s; SW_Cherry_MX_1.00u_PCB; Part Name MX1A-E1NW; Mouser 540-MX1A-E1NW
SW17: z; SW_Cherry_MX_1.00u_PCB; Part Name MX1A-E1NW; Mouser 540-MX1A-E1NW
SW18: Tux; SW_Cherry_MX_1.25u_PCB; Part Name MX1A-E1NW; Mouser 540-MX1A-E1NW
SW19: F3; SW_Cherry_MX_1.00u_PCB; Part Name MX1A-E1NW; Mouser 540-MX1A-E1NW
SW20: 3; SW_Cherry_MX_1.00u_PCB; Part Name MX1A-E1NW; Mouser 540-MX1A-E1NW
SW21: e; SW_Cherry_MX_1.00u_PCB; Part Name MX1A-E1NW; Mouser 540-MX1A-E1NW
SW22: d; SW_Cherry_MX_1.00u_PCB; Part Name MX1A-E1NW; Mouser 540-MX1A-E1NW
SW23: c; SW_Cherry_MX_1.00u_PCB; Part Name MX1A-E1NW; Mouser 540-MX1A-E1NW
SW24: Alt; SW_Cherry_MX_1.25u_PCB; Part Name MX1A-E1NW; Mouser 540-MX1A-E1NW
SW25: F4; SW_Cherry_MX_1.00u_PCB; Part Name MX1A-E1NW; Mouser 540-MX1A-E1NW
SW26: 4; SW_Cherry_MX_1.00u_PCB; Part Name MX1A-E1NW; Mouser 540-MX1A-E1NW
SW27: r; SW_Cherry_MX_1.00u_PCB; Part Name MX1A-E1NW; Mouser 540-MX1A-E1NW
SW28: f; SW_Cherry_MX_1.00u_PCB; Part Name MX1A-E1NW; Mouser 540-MX1A-E1NW
SW29: v; SW_Cherry_MX_1.00u_PCB; Part Name MX1A-E1NW; Mouser 540-MX1A-E1NW
SW31: F5; SW_Cherry_MX_1.00u_PCB; Part Name MX1A-E1NW; Mouser 540-MX1A-E1NW
SW32: 5; SW_Cherry_MX_1.00u_PCB; Part Name MX1A-E1NW; Mouser 540-MX1A-E1NW
SW33: t; SW_Cherry_MX_1.00u_PCB; Part Name MX1A-E1NW; Mouser 540-MX1A-E1NW
SW34: g; SW_Cherry_MX_1.00u_PCB; Part Name MX1A-E1NW; Mouser 540-MX1A-E1NW
SW35: b; SW_Cherry_MX_1.00u_PCB; Part Name MX1A-E1NW; Mouser 540-MX1A-E1NW
SW36: F6; SW_Cherry_MX_1.00u_PCB; Part Name MX1A-E1NW; Mouser 540-MX1A-E1NW
SW37: 6; SW_Cherry_MX_1.00u_PCB; Part Name MX1A-E1NW; Mouser 540-MX1A-E1NW
SW38: y; SW_Cherry_MX_1.00u_PCB; Part Name MX1A-E1NW; Mouser 540-MX1A-E1NW
SW39: h; SW_Cherry_MX_1.00u_PCB; Part Name MX1A-E1NW; Mouser 540-MX1A-E1NW
SW40: n; SW_Cherry_MX_1.00u_PCB; Part Name MX1A-E1NW; Mouser 540-MX1A-E1NW
SW41: F7; SW_Cherry_MX_1.00u_PCB; Part Name MX1A-E1NW; Mouser 540-MX1A-E1NW
SW42: 7; SW_Cherry_MX_1.00u_PCB; Part Name MX1A-E1NW; Mouser 540-MX1A-E1NW
SW43: u; SW_Cherry_MX_1.00u_PCB; Part Name MX1A-E1NW; Mouser 540-MX1A-E1NW
SW44: j; SW_Cherry_MX_1.00u_PCB; Part Name MX1A-E1NW; Mouser 540-MX1A-E1NW
SW45: m; SW_Cherry_MX_1.00u_PCB; Part Name MX1A-E1NW; Mouser 540-MX1A-E1NW
SW46: Space; SW_Cherry_MX_6.25u_PCB; Part Name MX1A-E1NW; Mouser 540-MX1A-E1NW
SW47: F8; SW_Cherry_MX_1.00u_PCB; Part Name MX1A-E1NW; Mouser 540-MX1A-E1NW
SW48: 8; SW_Cherry_MX_1.00u_PCB; Part Name MX1A-E1NW; Mouser 540-MX1A-E1NW
SW49: i; SW_Cherry_MX_1.00u_PCB; Part Name MX1A-E1NW; Mouser 540-MX1A-E1NW
SW50: k; SW_Cherry_MX_1.00u_PCB; Part Name MX1A-E1NW; Mouser 540-MX1A-E1NW
SW51: comma; SW_Cherry_MX_1.00u_PCB; Part Name MX1A-E1NW; Mouser 540-MX1A-E1NW
SW52: F9; SW_Cherry_MX_1.00u_PCB; Part Name MX1A-E1NW; Mouser 540-MX1A-E1NW
SW53: 9; SW_Cherry_MX_1.00u_PCB; Part Name MX1A-E1NW; Mouser 540-MX1A-E1NW
SW54: o; SW_Cherry_MX_1.00u_PCB; Part Name MX1A-E1NW; Mouser 540-MX1A-E1NW
SW55: l; SW_Cherry_MX_1.00u_PCB; Part Name MX1A-E1NW; Mouser 540-MX1A-E1NW
SW56: dot; SW_Cherry_MX_1.00u_PCB; Part Name MX1A-E1NW; Mouser 540-MX1A-E1NW
SW57: F10; SW_Cherry_MX_1.00u_PCB; Part Name MX1A-E1NW; Mouser 540-MX1A-E1NW
SW58: 0; SW_Cherry_MX_1.00u_PCB; Part Name MX1A-E1NW; Mouser 540-MX1A-E1NW
SW59: p; SW_Cherry_MX_1.00u_PCB; Part Name MX1A-E1NW; Mouser 540-MX1A-E1NW
SW60: semicolon; SW_Cherry_MX_1.00u_PCB; Part Name MX1A-E1NW; Mouser 540-MX1A-E1NW
SW61: slash; SW_Cherry_MX_1.00u_PCB; Part Name MX1A-E1NW; Mouser 540-MX1A-E1NW
SW62: Alt Gr; SW_Cherry_MX_1.00u_PCB; Part Name MX1A-E1NW; Mouser 540-MX1A-E1NW
SW63: F11; SW_Cherry_MX_1.00u_PCB; Part Name MX1A-E1NW; Mouser 540-MX1A-E1NW
SW64: minus; SW_Cherry_MX_1.00u_PCB; Part Name MX1A-E1NW; Mouser 540-MX1A-E1NW
SW65: sq br open; SW_Cherry_MX_1.00u_PCB; Part Name MX1A-E1NW; Mouser 540-MX1A-E1NW
SW66: apostrophe; SW_Cherry_MX_1.00u_PCB; Part Name MX1A-E1NW; Mouser 540-MX1A-E1NW
SW67: Menu; SW_Cherry_MX_1.00u_PCB; Part Name MX1A-E1NW; Mouser 540-MX1A-E1NW
SW68: F12; SW_Cherry_MX_1.00u_PCB; Part Name MX1A-E1NW; Mouser 540-MX1A-E1NW
SW69: equal; SW_Cherry_MX_1.00u_PCB; Part Name MX1A-E1NW; Mouser 540-MX1A-E1NW
SW70: sq br close; SW_Cherry_MX_1.00u_PCB; Part Name MX1A-E1NW; Mouser 540-MX1A-E1NW
SW71: backslash; SW_Cherry_MX_1.00u_PCB; Part Name MX1A-E1NW; Mouser 540-MX1A-E1NW
SW72: Shift; SW_Cherry_MX_1.75u_PCB; Part Name MX1A-E1NW; Mouser 540-MX1A-E1NW
SW73: Ctrl; SW_Cherry_MX_1.00u_PCB; Part Name MX1A-E1NW; Mouser 540-MX1A-E1NW
SW74: Print; SW_Cherry_MX_1.00u_PCB; Part Name MX1A-E1NW; Mouser 540-MX1A-E1NW
SW75: Backspace; SW_Cherry_MX_2.00u_PCB; Part Name MX1A-E1NW; Mouser 540-MX1A-E1NW
SW76: Enter; SW_Cherry_MX_ISOEnter_PCB; Part Name MX1A-E1NW; Mouser 540-MX1A-E1NW
SW77: Left; SW_Cherry_MX_1.00u_PCB; Part Name MX1A-E1NW; Mouser 540-MX1A-E1NW
SW78: Scroll Lock; SW_Cherry_MX_1.00u_PCB; Part Name MX1A-E1NW; Mouser 540-MX1A-E1NW
SW79: Up; SW_Cherry_MX_1.00u_PCB; Part Name MX1A-E1NW; Mouser 540-MX1A-E1NW
SW80: Down; SW_Cherry_MX_1.00u_PCB; Part Name MX1A-E1NW; Mouser 540-MX1A-E1NW
SW81: Pause; SW_Cherry_MX_1.00u_PCB; Part Name MX1A-E1NW; Mouser 540-MX1A-E1NW
SW82: INS; SW_Cherry_MX_1.00u_PCB; Part Name MX1A-E1NW; Mouser 540-MX1A-E1NW
SW83: DEL; SW_Cherry_MX_1.00u_PCB; Part Name MX1A-E1NW; Mouser 540-MX1A-E1NW
SW84: Page Up; SW_Cherry_MX_1.00u_PCB; Part Name MX1A-E1NW; Mouser 540-MX1A-E1NW
SW85: Page Down; SW_Cherry_MX_1.00u_PCB; Part Name MX1A-E1NW; Mouser 540-MX1A-E1NW
SW86: Right; SW_Cherry_MX_1.00u_PCB; Part Name MX1A-E1NW; Mouser 540-MX1A-E1NW
SW87: x; SW_Cherry_MX_1.00u_PCB; Part Name MX1A-E1NW; Mouser 540-MX1A-E1NW
U2: 74LV595; TSSOP-16_4.4x5mm_P0.65mm; Mouser 771-74LV595PW-T
U3, U4: 74LV165; TSSOP-16_4.4x5mm_P0.65mm; Mouser 771-LV165PW112

Connections:
/MCU/165_~CE: U3.15 (~CE), U4.15 (~CE); also elsewhere on the board
/MCU/165_~PL: U3.1 (~PL), U4.1 (~PL); also elsewhere on the board
/MCU/SPI_MISO: U3.9 (Q7); also elsewhere on the board
/MCU/SPI_MOSI: U2.14 (SER); also elsewhere on the board
/MCU/SPI_SCK: U2.11 (SRCLK), U2.12 (RCLK), U3.2 (CP), U4.2 (CP); also elsewhere on the board
/VCC_KEYS: C4.1, C5.1, C6.1, R32.1, R33.1, R34.1, R35.1, R36.1, R37.1, R38.1, R39.1, R40.1, R41.1, R42.1, R43.1, R44.1, R45.1, R46.1, R47.1, U2.10 (~SRCLR), U2.16 (VCC), U3.16 (VCC), U4.16 (VCC); also elsewhere on the board
GND: C4.2, C5.2, C6.2, U2.8 (GND), U2.13 (~OE), U3.8 (GND), U4.8 (GND); also elsewhere on the board
unnamed: D1.1, SW2.1
unnamed: D1.2, SW1.1
unnamed: D1.3, D7.3, D13.3, D18.3, D24.3, D29.3, D35.3, D41.3, U2.2 (QC)
unnamed: D2.1, SW8.1
unnamed: D2.2, SW3.1
unnamed: D3.1, SW9.1
unnamed: D3.2, SW4.1
unnamed: D4.1, SW10.1
unnamed: D4.2, SW5.1
unnamed: D5.1, SW12.1
unnamed: D5.2, SW6.1
unnamed: D6.1, SW18.1
unnamed: D6.2, SW7.1
unnamed: D7.1, SW19.1
unnamed: D7.2, SW13.1
unnamed: D8.1, SW20.1
unnamed: D8.2, SW14.1
unnamed: D9.1, SW21.1
unnamed: D9.2, SW15.1
unnamed: D10.1, SW22.1
unnamed: D10.2, SW16.1
unnamed: D4.3, D10.3, D16.3, D21.3, D27.3, D32.3, D38.3, U2.4 (QE)
unnamed: D11.1, SW87.1
unnamed: D11.2, SW17.1
unnamed: D5.3, D11.3, D17.3, D22.3, D28.3, D33.3, D39.3, D43.3, U2.7 (QH)
unnamed: D12.1, SW46.1
unnamed: D12.2, SW24.1
unnamed: D6.3, D12.3, D34.3, D40.3, D44.3, U2.6 (QG)
unnamed: D13.1, SW31.1
unnamed: D13.2, SW25.1
unnamed: D14.1, SW32.1
unnamed: D14.2, SW26.1
unnamed: D2.3, D8.3, D14.3, D19.3, D25.3, D30.3, D36.3, D42.3, U2.1 (QB)
unnamed: D15.1, SW33.1
unnamed: D15.2, SW27.1
unnamed: D3.3, D9.3, D15.3, D20.3, D26.3, D31.3, D37.3, U2.3 (QD)
unnamed: D16.1, SW34.1
unnamed: D16.2, SW28.1
unnamed: D17.1, SW29.1
unnamed: D17.2, SW23.1
unnamed: D18.1, SW41.1
unnamed: D18.2, SW36.1
unnamed: D19.1, SW42.1
unnamed: D19.2, SW37.1
unnamed: D20.1, SW43.1
unnamed: D20.2, SW38.1
unnamed: D21.1, SW44.1
unnamed: D21.2, SW39.1
unnamed: D22.1, SW40.1
unnamed: D22.2, SW35.1
unnamed: D24.1, SW52.1
unnamed: D24.2, SW47.1
unnamed: D25.1, SW53.1
unnamed: D25.2, SW48.1
unnamed: D26.1, SW54.1
unnamed: D26.2, SW49.1
unnamed: D27.1, SW55.1
unnamed: D27.2, SW50.1
unnamed: D28.1, SW51.1
unnamed: D28.2, SW45.1
unnamed: D29.1, SW63.1
unnamed: D29.2, SW57.1
unnamed: D30.1, SW64.1
unnamed: D30.2, SW58.1
unnamed: D31.1, SW65.1
unnamed: D31.2, SW59.1
unnamed: D32.1, SW66.1
unnamed: D32.2, SW60.1
unnamed: D33.1, SW61.1
unnamed: D33.2, SW56.1
unnamed: D34.1, SW67.1
unnamed: D34.2, SW62.1
unnamed: D35.1, SW74.1
unnamed: D35.2, SW68.1
unnamed: D36.1, SW75.1
unnamed: D36.2, SW69.1
unnamed: D37.1, SW76.1
unnamed: D37.2, SW70.1
unnamed: D38.1, SW84.1
unnamed: D38.2, SW71.1
unnamed: D39.2, SW72.1
unnamed: D40.1, SW77.1
unnamed: D40.2, SW73.1
unnamed: D41.1, SW81.1
unnamed: D41.2, SW78.1
unnamed: D42.1, SW82.1
unnamed: D42.2, SW83.1
unnamed: D43.1, SW85.1
unnamed: D43.2, SW79.1
unnamed: D44.1, SW86.1
unnamed: D44.2, SW80.1
unnamed: R32.2, SW1.2, SW3.2, SW4.2, SW5.2, SW6.2, SW7.2, U3.5 (D6)
unnamed: R33.2, SW2.2, SW8.2, SW9.2, SW10.2, SW12.2, SW18.2, U3.6 (D7)
unnamed: R34.2, SW13.2, SW14.2, SW15.2, SW16.2, SW17.2, SW24.2, U3.4 (D5)
unnamed: R35.2, SW19.2, SW20.2, SW21.2, SW22.2, SW87.2, U3.3 (D4)
unnamed: R36.2, SW23.2, SW25.2, SW26.2, SW27.2, SW28.2, U3.14 (D3)
unnamed: R37.2, SW29.2, SW31.2, SW32.2, SW33.2, SW34.2, U3.13 (D2)
unnamed: R38.2, SW35.2, SW36.2, SW37.2, SW38.2, SW39.2, SW46.2, U3.12 (D1)
unnamed: R39.2, SW40.2, SW41.2, SW42.2, SW43.2, SW44.2, U3.11 (D0)
unnamed: R40.2, SW45.2, SW47.2, SW48.2, SW49.2, SW50.2, U4.5 (D6)
unnamed: R41.2, SW51.2, SW52.2, SW53.2, SW54.2, SW55.2, U4.6 (D7)
unnamed: R42.2, SW56.2, SW57.2, SW58.2, SW59.2, SW60.2, SW62.2, U4.4 (D5)
unnamed: R43.2, SW61.2, SW63.2, SW64.2, SW65.2, SW66.2, SW67.2, U4.3 (D4)
unnamed: R44.2, SW68.2, SW69.2, SW70.2, SW71.2, SW72.2, SW73.2, U4.13 (D2)
unnamed: R45.2, SW74.2, SW75.2, SW76.2, SW77.2, U4.14 (D3)
unnamed: R46.2, SW78.2, SW79.2, SW80.2, SW83.2, U4.12 (D1)
unnamed: R47.2, SW81.2, SW82.2, SW84.2, SW85.2, SW86.2, U4.11 (D0)
unnamed: U3.10 (DS), U4.9 (Q7)

Notes on the sheet:
TODO: Connect ~SRCLR and ~OE to MCU pins?
TODO: pull-ups for each column

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
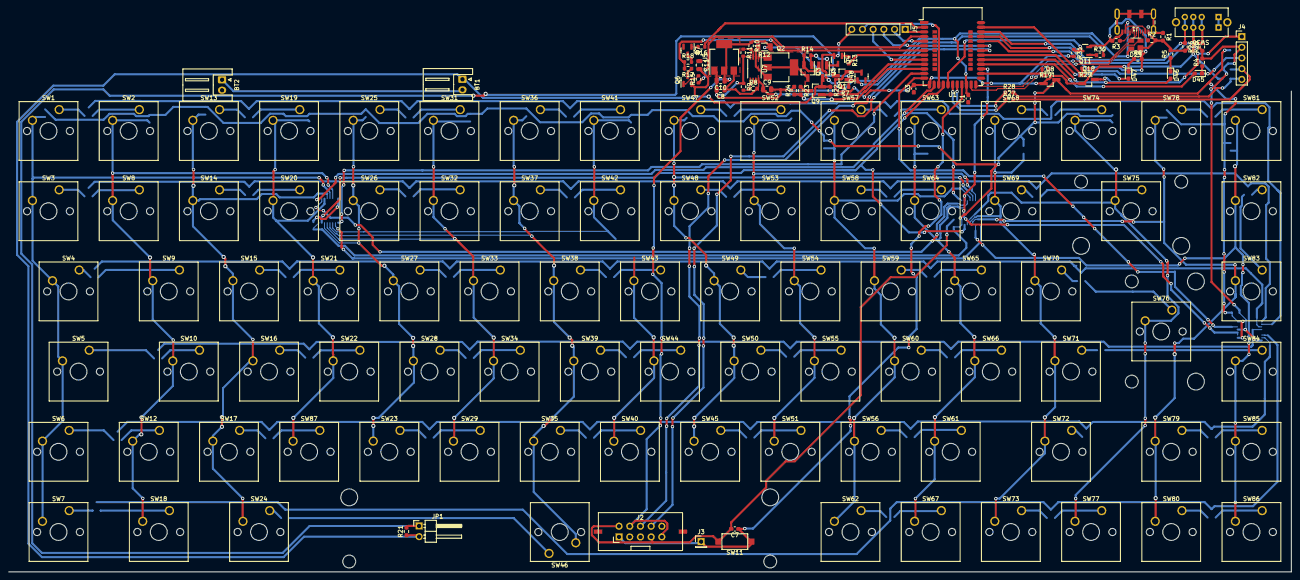
[picture p19: board goboard-main.kicad_pcb from above]

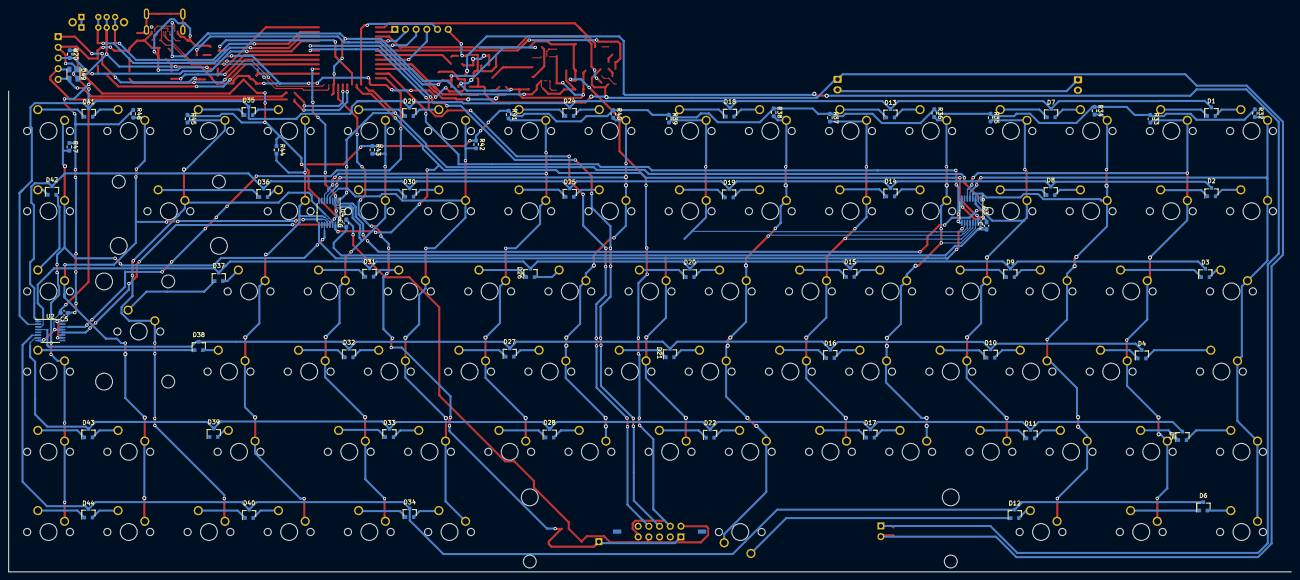
[picture p20: board goboard-main.kicad_pcb from below]

Board: 2 copper layers, 218 parts (67 on the bottom side), 171 nets.
