BerndGottschlag/goboard/firmware/main-rust/app/src/key_matrix.rs

use keyboard::keys::KeyMatrixHardware;

use embassy_embedded_hal::SetConfig;
use embassy_nrf::gpio::{Level, Output, OutputDrive};
use embassy_nrf::peripherals::{P0_04, P0_05, P0_07, P0_12, P0_22, P1_00, SPI3};
use embassy_nrf::{bind_interrupts, spim, spis};

bind_interrupts!(struct Irqs {
    SPIM3 => spim::InterruptHandler<SPI3>;
});

pub struct KeyMatrix {
    n_power: Output<'static, P0_22>,
    store: Output<'static, P0_12>,
    n_load: Output<'static, P0_07>,
    spi: spim::Spim<'static, SPI3>,
}

impl KeyMatrix {
    pub fn new(
        power_pin: P0_22,
        store_pin: P0_12,
        load_pin: P0_07,
        spi: SPI3,
        sck_pin: P1_00,
        mosi_pin: P0_05,
        miso_pin: P0_04,
    ) -> KeyMatrix {
        // The power and load pins are active-low.
        let n_power = Output::new(power_pin, Level::High, OutputDrive::Standard);
        let store = Output::new(store_pin, Level::Low, OutputDrive::Standard);
        let n_load = Output::new(load_pin, Level::High, OutputDrive::Standard);

        // The shift registers are driven via SPI.
        let mut config = spim::Config::default();
        config.frequency = spim::Frequency::M2;
        let spi = spim::Spim::new(spi, Irqs, sck_pin, miso_pin, mosi_pin, config);

        KeyMatrix {
            n_power,
            store,
            n_load,
            spi,
        }
    }
}

impl Drop for KeyMatrix {
    fn drop(&mut self) {
        // TODO: Additional current consumption because GPIOs are not low?
        // TODO: Do we want to do this at all?
        self.n_load.set_high();
        self.store.set_low();
        self.disable();
    }
}

impl KeyMatrixHardware for KeyMatrix {
    async fn enable(&mut self) {
        self.n_power.set_low();
        // We need to wait for some time to make sure that all the capacitance
        // is charged.
        embassy_time::Timer::after(embassy_time::Duration::from_millis(2)).await;
    }

    fn disable(&mut self) {
        self.n_power.set_high();
    }

    async fn read_row(&mut self, row_bitmap: u8) -> u16 {
        // The row selection lines are active-low.
        let row_bitmap = !row_bitmap << 1;
        // Write the row to the output shift register.
        // The two shift registers use different SPI modes, so we cannot use one transfer to
        // read/write both at the same time.
        let mut config = spim::Config::default();
        config.frequency = spim::Frequency::M2;
        config.mode = spis::Mode {
            polarity: spis::Polarity::IdleHigh,
            phase: spis::Phase::CaptureOnSecondTransition,
        };
        self.spi.set_config(&config).unwrap();
        let mut rx = [0];
        let tx = [row_bitmap];
        self.spi.transfer(&mut rx, &tx).await.unwrap();

        // Perform serial-to-parallel conversion to select the row.
        self.store.set_high();
        // TODO: Use cortex_m::asm::delay();
        embassy_time::Timer::after(embassy_time::Duration::from_micros(1)).await;
        self.store.set_low();
        embassy_time::Timer::after(embassy_time::Duration::from_micros(1)).await;

        // Perform parallel-to-serial conversion to read one row.
        self.n_load.set_low();
        embassy_time::Timer::after(embassy_time::Duration::from_micros(1)).await;
        self.n_load.set_high();
        embassy_time::Timer::after(embassy_time::Duration::from_micros(1)).await;

        // Read the input shift register.
        let mut config = spim::Config::default();
        config.frequency = spim::Frequency::M2;
        config.mode = spis::Mode {
            polarity: spis::Polarity::IdleHigh,
            phase: spis::Phase::CaptureOnFirstTransition,
        };
        self.spi.set_config(&config).unwrap();
        let mut rx = [0, 0];
        let tx = [0, 0];
        self.spi.transfer(&mut rx, &tx).await.unwrap();
        !rx[1] as u16 | ((!rx[0] as u16) << 8)
    }
}
