BerndGottschlag/goboard/firmware/main/src/leds.cpp

#include "leds.hpp"

Leds::Leds() {
	// TODO
}

Leds::~Leds() {
	// TODO
}

void Leds::set_mode(ModeLed mode) {
	ARG_UNUSED(mode);
	// TODO
}

void Leds::set_caps_lock(bool caps_lock) {
	ARG_UNUSED(caps_lock);
	// TODO
}

void Leds::set_scroll_lock(bool scroll_lock) {
	ARG_UNUSED(scroll_lock);
	// TODO
}
