BerndGottschlag/goboard/(commit log)

2020-12-23 hardware: Add empty Kicad projects.
    [goboard-main.kicad_pcb, goboard-main.kicad_sch, goboard-numpad.kicad_pcb, goboard-numpad.kicad_sch]
2020-12-25 Add keyboard layout and necessary 3d packages
    [goboard-main.kicad_pcb, goboard-main.kicad_sch, keys.kicad_sch, mcu.kicad_sch]
2020-12-25 hardware: Add a "power" sub-schematic for the power supply.
    [goboard-main.kicad_sch, power.kicad_sch]
2020-12-28 Implement the key matrix on the PCB
    [goboard-main.kicad_pcb, goboard-main.kicad_sch, keys.kicad_sch]
2020-12-29 Add footprint for the Holyiot-18010-NRF5284
2020-12-30 Add circuit for the shift registers
    [goboard-main.kicad_pcb, goboard-main.kicad_sch, keys.kicad_sch]
2020-12-30 Add first schematic for the numpad
    [goboard-numpad.kicad_sch, keys.kicad_sch]
2020-12-31 Fix pin of the symbol of the Holyiot breakout board
2020-12-31 Add footprint for the USB-C jack JAE DX07S016JA1R1500
2020-12-31 Add circuit for the USB-connector
    [goboard-main.kicad_pcb, goboard-main.kicad_sch]
2021-01-01 Update the PCB
    [goboard-main.kicad_pcb, goboard-main.kicad_sch]
2021-01-01 Add the missing MISO to the connector
    [goboard-numpad.kicad_sch, keys.kicad_sch]
2021-01-01 Add connector to the numpad to the schematic
    [goboard-main.kicad_pcb, goboard-main.kicad_sch, keys.kicad_sch, mcu.kicad_sch]
2021-01-01 WIP: numpad with an ATtiny
    As the newer versions of the ATtiny cannot be programmed using an
    In-Circuit-Programmer based on SPI this variant is not pursued further.
    [goboard-numpad.kicad_sch, keys.kicad_sch, mcu.kicad_sch]
2021-01-02 Exchange the ATtiny with a STM32L011F4P6 for the numpad
    [goboard-numpad.kicad_sch, mcu.kicad_sch]
2021-01-02 Add list with needed parts not present in the schematics
2021-01-02 Modify the connection to the numpad
    As the numpad now uses a stm-microcontroller instead of the
    shift-registers the connection is changed to UART.
    [goboard-main.kicad_sch, keys.kicad_sch]
2021-01-02 Add programming/debug connection
    [goboard-main.kicad_sch, keys.kicad_sch, mcu.kicad_sch]
2021-01-02 Fix MISO label for the shift registers
    [keys.kicad_sch]
2021-01-02 Add connections to the NRF module
    [goboard-main.kicad_sch, keys.kicad_sch, mcu.kicad_sch]
2021-01-02 Remove UART line from the NRF to the numpad
    [goboard-main.kicad_sch, goboard-numpad.kicad_sch, mcu.kicad_sch]
2021-01-02 Add footprints to many symbols
    [goboard-main.kicad_sch, keys.kicad_sch, mcu.kicad_sch]
2021-01-02 Add no-connect-symbols to the NRF
    [mcu.kicad_sch]
2021-01-02 Update PCB
    [goboard-main.kicad_pcb]
2021-01-03 Add annotations
    [goboard-main.kicad_sch, mcu.kicad_sch]
2021-01-03 Add specialized connector for the programming port
    [goboard-main.kicad_pcb, goboard-main.kicad_sch, keys.kicad_sch, mcu.kicad_sch]
2021-01-09 Add a line for the UART direction main->numpad
    This is necessary as the numlock-led is situated on the numpad and the
    main mcu has to be able to switch it on and off.
    [goboard-main.kicad_sch, goboard-numpad.kicad_sch, keys.kicad_sch, mcu.kicad_sch]
2021-01-09 Adapt the layout for another keycap set
    The layout is now compatible with this keycap set:
    https://hk-gaming.com/collections/keycaps/products/hk-gaming-dye-
    sublimation-cherry-profile-thick-pbt-keysets-for-mechanical-keyboard-139
    -keys-chalk
    [goboard-main.kicad_pcb, goboard-main.kicad_sch, keys.kicad_sch, mcu.kicad_sch]
2021-01-09 Add outline of a shrouded pin header to the programming connector
    [goboard-main.kicad_pcb]
2021-01-16 Add power supply from the debugging connector
    The batteries have to be disconnected when the debugger is plugged in,
    as the voltages differ (ca. 2V for the batteries, 3.3V for the
    debugger).
    [goboard-main.kicad_sch, keys.kicad_sch, mcu.kicad_sch, power.kicad_sch]
2021-01-16 Changes due to version update of kicad
    [goboard-main.kicad_pcb]
2021-01-16 Add kicad autosave files to gitignore
2021-01-16 Add new board outline
    Reason: This makes the first design iteration of the case possible.
    [goboard-main.kicad_pcb, goboard-main.kicad_sch, power.kicad_sch]
2021-01-16 Fix footprint of the capacitors
    [goboard-main.kicad_pcb, goboard-main.kicad_sch, keys.kicad_sch, mcu.kicad_sch]
2021-01-16 Add first rough version of the numpad PCB
    [goboard-numpad.kicad_pcb, goboard-numpad.kicad_sch, keys.kicad_sch, mcu.kicad_sch]
2021-01-16 Redo board edge outline
    [goboard-numpad.kicad_pcb]
2021-01-16 Fix path to the 3d model of the USB-C jack
    [goboard-main.kicad_pcb]
2021-01-17 Change value field for the backslash-key
    The value "\" caused the FreeCAD-StepUp load to fail due to a parsing
    error.
    [goboard-main.kicad_pcb, goboard-main.kicad_sch, keys.kicad_sch]
2021-01-20 Write out the symbol names for the keys
    [goboard-main.kicad_pcb, goboard-main.kicad_sch, keys.kicad_sch]
2021-01-20 Add MCU-controlled battery balancing.
    [goboard-main.kicad_sch, power.kicad_sch]
2021-01-20 Revert to a key layout with a menu key between alt gr and ctrl
    [goboard-main.kicad_pcb, goboard-main.kicad_sch, keys.kicad_sch]
2021-01-20 Add power supply and battery charging circuitry.
    [goboard-main.kicad_sch, power.kicad_sch]
2021-01-20 Fix power supply footprints and set references.
    [goboard-main.kicad_sch, power.kicad_sch]
2021-01-23 Add signal to tell the MCU that USB is connected.
    [goboard-main.kicad_sch, power.kicad_sch]
2021-01-24 Add switch to choose the connection type
    [goboard-main.kicad_sch, keys.kicad_sch, mcu.kicad_sch, power.kicad_sch]
2021-01-24 Add footprint and 3D-model for the sliding switch
    [EG2315A.FCStd, EG2315A.step, goboard-main.kicad_pcb, goboard-main.kicad_sch]
2021-01-24 Assign footprints
    [goboard-main.kicad_pcb, goboard-main.kicad_sch, power.kicad_sch]
2021-01-24 Fix errors found by ERC
    [goboard-main.kicad_sch, keys.kicad_sch, mcu.kicad_sch, power.kicad_sch]
2021-01-25 WIP: Design of PCB
    [goboard-main.kicad_pcb, goboard-main.kicad_sch, keys.kicad_sch, mcu.kicad_sch, power.kicad_sch]
2021-01-25 Route traces for the shift registers
    [goboard-main.kicad_pcb, goboard-main.kicad_sch, keys.kicad_sch]
2021-01-25 Add battery voltage measurement circuit
    [goboard-main.kicad_sch, mcu.kicad_sch]
2021-01-25 Fix symbol for the Holyiot board
    V_BUS pin was missing from the symbol.
2021-01-25 Add V_BUS connection for the MCU board
    [goboard-main.kicad_pcb, goboard-main.kicad_sch, mcu.kicad_sch]
2021-01-25 Rework the off/bluetooth1/bluetooth2 switch connection
    To save energy an external pull-down resistor is added and the off
    position is not connected to the MCU.
    [goboard-main.kicad_pcb, goboard-main.kicad_sch, mcu.kicad_sch]
2021-01-25 Remove the USB sense curcuit
    As V_BUS is connected to the MCU it can detect when the USB is
    connected.
    [goboard-main.kicad_pcb, goboard-main.kicad_sch, mcu.kicad_sch, power.kicad_sch]
2021-01-25 Add circuit to disconnect the shift registers
    This is done to save energy when the keyboard is switched off.
    [goboard-main.kicad_pcb, goboard-main.kicad_sch, keys.kicad_sch, mcu.kicad_sch, power.kicad_sch]
2021-01-25 Rework the connection to the numpad
    Changes:
    - The UART lines now have a protection circuit
    - The power supply line of the numpad can be switched on and off by the MCU.
    - An Id-line is added so that the MCU can detect when the numpad is
    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
    [goboard-main.kicad_pcb, goboard-main.kicad_sch, mcu.kicad_sch, power.kicad_sch]
2021-01-25 Update the connection of the numpad
    The ID line is added to the numpad side and the connector pin assignment
    is updated.
    [goboard-numpad.kicad_sch, keys.kicad_sch, mcu.kicad_sch]
2021-01-27 firmware: Some stubs and code to light an LED.
2021-01-28 firmware: Implement a USB HID device.
2021-01-29 firmware: Poll a single button to simulate a key.
2021-01-30 Re-add USB voltage sense circuit
    Due to firmware limitations the USB voltage cannot be used directly for
    waking up the microcontroller.
    [goboard-main.kicad_pcb, goboard-main.kicad_sch, mcu.kicad_sch, power.kicad_sch]
2021-01-30 firmware: Add bluetooth and UART logging to the configuration.
2021-01-30 firmware: Use the NRF SDK scheduler and power management.
    This change breaks the timers currently used in key_matrix.c, but that code
    is rewritten anyways.
2021-01-30 Add the USB sense circuit to the PCB
    [goboard-main.kicad_sch, keys.kicad_sch, power.kicad_sch]
2021-01-31 firmware: Start to rework power management code.
2021-01-31 firmware: Add a simple mode LED.
2021-01-31 Add pull-up resistors to the key matrix
    [goboard-main.kicad_pcb, goboard-main.kicad_sch, keys.kicad_sch]
2021-01-31 Add header with debug pins
    [goboard-main.kicad_pcb, goboard-main.kicad_sch, mcu.kicad_sch]
2021-02-02 Changes due to updated kicad version
    [goboard-main.kicad_sch, keys.kicad_sch, mcu.kicad_sch, power.kicad_sch]
2021-02-02 Exchange the battery connector for a JST XH connector
    [goboard-main.kicad_pcb, goboard-main.kicad_sch, power.kicad_sch]
2021-02-04 Add ground planes
2021-02-05 Fix DRC errors
    Among others:
    - Arrange part identifiers on silkscreen
    - Fix clearance errors
2021-02-06 Change position of the battery connectors
    The previous position collided with the switches.
2021-02-06 Add 3D-packages for buttons with stabilizers
    [stabilizer_2_00u.FCStd, stabilizer_6_25u.FCStd, stabilizer__ISOEnter_PCB.FCStd, stabilizer_bar_2_00u.FCStd, stabilizer_bar_6_25u.FCStd, stabilizer_body.FCStd, stabilizer_plunger.FCStd]
2021-02-06 Fix footprint for the debugging connector
2021-02-06 hardware: Change key matrix/numpad voltage to be off by default.
    [goboard-main.kicad_sch, power.kicad_sch]
2021-02-06 hardware: Use bigger decoupling capacitors for the MCU module.
    [goboard-main.kicad_sch, mcu.kicad_sch]
2021-02-06 hardware: Use contiguous pins for the rows.
    Contiguous pins simplify programming as we can just shift a bit in a loop.
    [keys.kicad_sch]
2021-02-06 Numpad: add pullup resistors to the key matrix
    [keys.kicad_sch]
2021-02-06 Add footprints to two components
    [goboard-numpad.kicad_sch, mcu.kicad_sch]
2021-02-06 Numpad: exchange key identifer
    [goboard-numpad.kicad_sch, keys.kicad_sch, mcu.kicad_sch]
2021-02-06 Numpad: WIP: design PCB
    [goboard-numpad.kicad_pcb, keys.kicad_sch, mcu.kicad_sch]
2021-02-06 Numpad: Fix labels of columns and rows of the key matrix
    [goboard-numpad.kicad_pcb, goboard-numpad.kicad_sch, keys.kicad_sch, mcu.kicad_sch]
2021-02-06 Numpad: Create traces from the MCU to the keymatrix
    [goboard-numpad.kicad_pcb, mcu.kicad_sch]
2021-02-06 Numpad: Add last traces and ground plane
    [goboard-numpad.kicad_pcb]
2021-02-06 Numpad: Fix DRC errors
    Mainly placement of silkscreen content, track clearance violations and
    overlapping courtyards.
    [goboard-numpad.kicad_pcb]
2021-02-07 Main: Fix position of the Power-LED
2021-02-07 Fix the board outline
    The outline must not go beyond the outline of the keys except for
    certain areas at the north side.
2021-02-07 Main: Transfer the changes of Mathias Gottschlag to PCB
    Transfered changes of commits:
    17ca2a9548b7ad5bcafb4c4489e0f86f719de1c1
    726a2ce27092844aff245bdad9676d5f44ab9ae4
    f3c8f86b82ee067a7bff6dfa5026467c1d0aa33d
2021-02-09 Add separate LOAD and STORE connections to the shift registers.
    [goboard-main.kicad_sch, keys.kicad_sch, mcu.kicad_sch]
2021-02-13 Main: Transfer changes of Mathias Gottschlag to PCB
    Transfered changes of commit ebc08603c55c8ad816bef08a7e3718f1bc52cc4d.
2021-02-13 Numpad: Fix position of the power-led
    [goboard-numpad.kicad_pcb]
2021-02-13 Improve routing of a track
    [goboard-numpad.kicad_pcb]
2021-02-13 Main: Improve board outlines
    Add rounded corners and make the outline a bit smaller
2021-02-13 Main: Improve track routing
2021-02-13 Main: Fix datasheet link of the usb jack
    [goboard-main.kicad_sch]
2021-02-13 Main: Rework the footprint of the USB jack
    The width of the plated slots was less than needed for manufacturing by
    JLCPCB.
2021-02-13 Main: Tidy up traces and ground plates
2021-02-13 Main: Add a fuse to BATT+
    [goboard-main.kicad_sch, power.kicad_sch]
2021-02-13 Main: Move the connection to the numpad
    This was done to facilitate the routing of the cables to the
    pogo-pin-connector.
2021-02-13 Main: Review of schematics
    [goboard-main.kicad_sch, keys.kicad_sch, mcu.kicad_sch, power.kicad_sch]
2021-02-13 Review and fix footprints
2021-02-13 Main: Update pcb
    Add pull-up resistor for RESET.
2021-02-13 Main: Review of PCB
    [goboard-main.kicad_sch]
2021-02-20 Numpad: Rework PCB layout
    The Power-LED was eliminated and the Numpad-LED moved off the board.
    [goboard-numpad.kicad_pcb, goboard-numpad.kicad_sch, mcu.kicad_sch]
2021-02-20 Numpad: Add break-away board with the numpad LED
    [goboard-numpad.kicad_pcb, goboard-numpad.kicad_sch, mcu.kicad_sch]
2021-02-20 Numpad: Adjust the board outline of the break-away tab
    [goboard-numpad.kicad_pcb]
2021-02-20 Numpad: Exchange footprint of the numpad-LED connection
    The 2.54 mm pin-header did not fit between the switches as the
    silkscreens overlapped.
    [goboard-numpad.kicad_pcb, goboard-numpad.kicad_sch, mcu.kicad_sch]
2021-02-20 Numpad: Exchange the debug-conn footprint for one without silkscreen
    [goboard-numpad.kicad_pcb, goboard-numpad.kicad_sch]
2021-02-20 Numpad: Configure designrules for JLCPCB + Fix Errors
    [goboard-numpad.kicad_pcb]
2021-02-21 Numpad: Add missing part numbers
    [goboard-numpad.kicad_sch, keys.kicad_sch, mcu.kicad_sch]
2021-02-21 Numpad: Update PCB
    The footprint of two capacitors were changed.
    [goboard-numpad.kicad_pcb]
2021-02-21 Update .gitignore to exclude bom files generated by kicad
2021-02-21 Numpad: Add pullup for reset and connect BOOT0 to ground
    [goboard-numpad.kicad_sch, keys.kicad_sch, mcu.kicad_sch]
2021-02-21 Numpad: Connect the break-away-board to the main with traces
    This allows software development without having to solder the LED to the
    PCB with wires.
    [goboard-numpad.kicad_pcb, goboard-numpad.kicad_sch, mcu.kicad_sch]
2021-02-21 Numpad: Add power flag to satisfy the ERC
    [goboard-numpad.kicad_sch]
2021-02-21 Main & Numpad: Fix the pin-out of the programmer connector
    [goboard-main.kicad_sch, goboard-numpad.kicad_pcb, goboard-numpad.kicad_sch]
2021-02-21 Main: Update symbols
    [goboard-main.kicad_sch, mcu.kicad_sch, power.kicad_sch]
2021-02-22 Numpad: Exchange MCU for an available version
    [goboard-numpad.kicad_pcb, goboard-numpad.kicad_sch, mcu.kicad_sch]
2021-02-22 Main: WIP: Add mounting holes
    [goboard-main.kicad_sch, mounting_holes.kicad_sch]
2021-02-22 Main & Numpad: Exchange unavailable capacitors
    [goboard-main.kicad_sch, goboard-numpad.kicad_sch, keys.kicad_sch, mcu.kicad_sch]
2021-02-22 Main: Exchange voltage regulator for an available unit
    [goboard-main.kicad_sch, power.kicad_sch]
2021-02-22 Main: Fix footprint assignment of part
    [goboard-main.kicad_sch, power.kicad_sch]
2021-02-27 Main: Add mounting holes
    [goboard-main.kicad_sch, mounting_holes.kicad_sch]
2021-02-27 hardware: Various small PCB and schematics fixes/improvements.
    - 3.3V and 3.3V_programmer used to be the same net.
    - Lots of ground plane fixes for a more contiguous ground plane.
    - Reordered some MCU pins for a better layout.
    [goboard-main.kicad_sch, mcu.kicad_sch, power.kicad_sch]
2021-02-28 Numpad: Add mounting holes
    [goboard-numpad.kicad_pcb, goboard-numpad.kicad_sch, keys.kicad_sch, mounting_holes.kicad_sch]
2021-02-28 Numpad: Re-route traces to improve ground plane
    [goboard-numpad.kicad_pcb]
2021-02-28 main: Ground plane repairs, via stitching.
2021-02-28 Main & Numpad: Add release info to PCBs
    [goboard-numpad.kicad_pcb]
2021-02-28 Main: Add gerber setup
2021-02-28 Numpad: Add gerber setup and update groundplane fill
    [goboard-numpad.kicad_pcb]
2021-03-03 firmware: Fix a warning.
    [mode_led.c, mode_led.h]
2021-03-03 firmware: Make the mode switch profiles configurable.
2021-03-13 firmware: Add a custom board definition for the main keyboard.
2021-03-13 firmware: C++ stubs for power supply and mode switch.
2021-03-13 firmware: Add missing exception class.
    [exception.hpp]
2021-03-13 firmware: Add missing default configuration and fix PWM support for LEDs.
2021-03-13 firmware: Let a LED blink for debugging.
2021-03-14 firmware: Fix wrong key matrix method return types.
    [key_matrix.cpp, key_matrix.hpp]
2021-03-19 firmware: Add stubs for the power supply code.
2021-03-19 firmware: Add tests for the battery charging logic.
2021-03-20 firmware: Add mode switch API stubs.
2021-03-20 firmware: Add main mode switch/shutdown logic.
2021-03-20 firmware: Misc minor fixes.
    [main.cpp]
2021-03-21 firmware: Implement battery charging/balancing.
2021-03-23 firmware: Add power supply pins to the device tree.
2021-03-28 Hardware main: correct datasheets of shift registers
    [goboard-main.kicad_sch, keys.kicad_sch, mcu.kicad_sch, power.kicad_sch]
2021-03-28 Firmware: Fix assert for mock key_matrix function select_row
    [keys.cpp]
2021-03-28 Main: Firmware: Fix key mapping (support duplicated key mappings).
    KEY_INVALID appeared multiple times in the key matrix mapping, so the
    second occurance overwrote the first. As the key bitmap is initially
    cleared anyways, the clear_bit() for non-pressed keys can be removed to
    prevent this behavior.
    [keys.cpp, keys.hpp]
2021-03-28 Main: Firmware: Implement measuring the battery voltage.
    The state of charge is not calculated yet, and the USB connection is not
    yet detected.
2021-03-29 Main: Firmware: Implement power supply state callbacks.
2021-03-29 Main: Firmware: Fix a race condition on PowerSupply::has_usb_connection().
    [power_supply.cpp, power_supply.hpp]
2021-03-30 Main: Firmware: Rename parameters in power_supply.hpp to match .cpp.
2021-03-30 Main: Firmware: Extend KeyBitmap (find pressed keys, "==", fix overflows).
    [keys.cpp, keys.hpp]
2021-03-30 Main: Firmware: Test KeyBitmap::bit_is_set() and fix tests.
    [keys.cpp]
2021-03-30 Main: Firmware: Fix printk linebreaks and reduce debug spam during tests.
    [main.cpp, power_supply.cpp]
2021-03-31 Main: Firmware: Fix USB SOF events and key change detection.
    [usb.cpp]
2021-03-31 Main: Firmware: Swap key rows to match the hardware.
    [keys.cpp]
2021-03-31 Main: Firmware: Remove some UART debug spam.
2021-03-31 Main: Firmware: Implement the mode switch.
2021-04-02 Main: Firmware: Stub functions for the LEDs.
2021-04-05 Main: Firmware: Implement FN combination mapping and fix the tests.
    [keys.cpp, keys.hpp]
2023-02-04 firmware: Fix SPI settings in the Rust code.
    [key_matrix.rs]
2023-02-04 firmware: Add mode switch and power supply code (incomplete).
2023-02-04 Added a unit test for the battery charging code.
2023-02-05 firmware: Added rust power supply code (copied from the C++ firmware).
2024-02-04 Draft code for power management/application structure.
2024-02-04 Use probe-rs instead of probe-run.
2024-02-04 Implement battery charging hardware (ADC, pins).
2024-02-08 Mode switch hardware support.
2024-02-16 Fix compiler errors due to embassy update.
    [mode_switch.rs]
2024-02-16 Some initial USB device code.
2024-03-05 CAD files for 3D-printed parts.
    [Abdeckung.scad, Abdeckung_v2.scad, Batteriehalter.scad, Batteriehalter_v2.scad, NumpadLEDHolder.scad, roundedcube.scad]
