BerndGottschlag/goboard/(notices)

Notices in the files:
hardware/numpad/goboard-numpad.kicad_pcb:
License: CERN Open
Hardware License v1.
